dwynnychuk/SmartSmoker/PCB/BOMs/ConsolodatedBoms.xlsx

ConsolodatedBoms
Item | Qty | Reference(s) | Value | Board | Footprint | Manufacturer | Manufacturer Part Number | Vendor | Vendor Part Number
3 | 3 | C12, C15, C16 | 0.01uF 50V X7R 0603 | Digital | Capacitor_SMD:C_0603_1608Metric | Samsung Electro-Mechanics | CL10B103KB8NNNC | Digikey | 1276-1009-1-ND
4 | 5 | - | 10uF 16V X5R 0805 | Digital/Analog | Capacitor_SMD:C_0805_2012Metric | Samsung Electro-Mechanics | CL21A106KOQNNNE | Digikey | 1276-1096-1-ND
2 | 2 | - | 1 uF 25V X5R 0603 | Digital/Signal | Capacitor_SMD:C_0603_1608Metric | Samsung Electro-Mechanics | CL10A105KA8NNNC | Digikey | 1276-1102-1-ND
5 | 2 | - | 4.7uF 25V X5R 0805 | Digital/Signal | Capacitor_SMD:C_0805_2012Metric | Samsung Electro-Mechanics | CL21A475KAQNNNE | Digikey | 1276-1244-1-ND
1 | 16 | - | 0.1uF 50V X7R 0603 | All | Capacitor_SMD:C_0603_1608Metric | Samsung Electro-Mechanics | CL10B104KB8NNWC | Digikey | 1276-1935-1-ND
6 | 1 | C4 | 22uF 10V X5R 0805 | Digital | Capacitor_SMD:C_0805_2012Metric | Samsung Electro-Mechanics | CL21A226MPQNNNE | Digikey | 1276-2910-1-ND
46 | 1 | R9 | 250Ohm 0.1% 0603 | Digital | Resistor_SMD:R_0603_1608Metric | YAGEO | RT0603BRE07250RL | Digikey | 13-RT0603BRE07250RLCT-ND
45 | 1 | R8 | 50Ohm 0.1% 0603 | Digital | Resistor_SMD:R_0603_1608Metric | YAGEO | RT0603BRE0750RL | Digikey | 13-RT0603BRE0750RLCT-ND
8 | 1 | TP26 | Screen I2C - FOR BOM ONLY | Digital | Connector_PinHeader_2.54mm:PinHeader_1x04_P2.54mm_Vertical | Adafruit Industries LLC | 938 | Digikey | 1528-1512-ND
24 | 1 | U1 | LTR-329ALS-01 | Sensor | Customs:LTR-329ALS-01 | Lite-On Inc. | LTR-329ALS-01 | Digikey | 160-2160-1-ND
10 | 1 | PS2 | IRM-05-5 | Analog | Converter_ACDC:Converter_ACDC_MeanWell_IRM-05-xx_THT | MEAN WELL USA Inc. | IRM-05-5 | Digikey | 1866-3027-ND
11 | 1 | PS1 | IRM-10-3.3 | Analog | Converter_ACDC:Converter_ACDC_MeanWell_IRM-10-xx_THT | MEAN WELL USA Inc. | IRM-10-3.3 | Digikey | 1866-3031-ND
12 | 1 | U2 | ESP32-WROOM-32UE_16MB | Digital | Customs Smoker:ESP32-WROOM-32UE 16MB | Espressif Systems | ESP32-WROOM-32UE-N4 | Digikey | 1965-ESP32-WROOM-32UE-N4CT-ND
20 | 1 | J6 | SJ3-35053D | Analog | Customs Smoker:SAMESKY_SJ3-35053D | SameSky | SJ3-35053D | Digkey | 2223-SJ3-35053D-ND
16 | 3 | U1, U2, U3 | ALDP105W | Analog | Customs Smoker:PAN_ALD_PAN | Panasonic Electric Works | ALDP105W | Digikey | 255-3586-ND
13 | 1 | J1 | DF12NB_4.0_-20DP-0.5V_51_ | Analog | Customs Smoker:HRS_DF12NB_4.0_-20DP-0.5V_51_ | Hirose | DF12NB(4.0)-20DP-0.5V(51) | Digikey | 26-DF12NB(4.0)-20DP-0.5V(51)CT-ND
14 | 1 | J1 | DF12NC-20DS-0.5V_51_ | Digital | Customs Smoker:HRS_DF12NC-20DS-0.5V_51_ | Hirose | DF12NC-20DS-0.5V(51) | Digikey | 26-DF12NC-20DS-0.5V(51)CT-ND
18 | 1 | U3 | TPS2115APWR | Digital | Customs Smoker:PW8-M | Texas Instruments | TPS2115APWR | Digikey | 296-16940-1-ND
35 | 5 | - | 0 Ohm 0603 | Digital/Analog | Resistor_SMD:R_0603_1608Metric | YAGEO | RC0603JR-070RL | Digikey | 311-0.0GRCT-ND
37 | 6 | - | 150Ohm 1% 0603 | Digital/Analog | Resistor_SMD:R_0603_1608Metric | YAGEO | RC0603FR-07150RL | Digikey | 311-150HRCT-ND
42 | 1 | R13 | 22.1kOhm 1% 0603 | Digital | Resistor_SMD:R_0603_1608Metric | YAGEO | RC0603FR-0722K1L | Digikey | 311-22.1KHRCT-ND
43 | 1 | R20 | 47.5kOhm 1% 0603 | Digital | Resistor_SMD:R_0603_1608Metric | YAGEO | RC0603FR-0747K5L | Digikey | 311-47.5KHRCT-ND
38 | 4 | - | 64.9Ohm 1% 0603 | Digital/Analog | Resistor_SMD:R_0603_1608Metric | YAGEO | RC0603FR-0764R9L | Digikey | 311-64.9HRCT-ND
39 | 1 | R1 | 750Ohm 1% 0603 | Sensor | Resistor_SMD:R_0603_1608Metric | YAGEO | RC0603FR-07750RL | Digikey | 311-750HRCT-ND
40 | 3 | R1, R6, R9 | 91Ohm 1% 0603 | Analog | Resistor_SMD:R_0603_1608Metric | YAGEO | RC0603FR-0791RL | Digikey | 311-91.0HRCT-ND
29 | 1 | U6 | CP2102N-A02-GQFN24 | Digital | Package_DFN_QFN:QFN-24-1EP_4x4mm_P0.5mm_EP2.6x2.6mm | Silicon Labs | CP2102N-A02-GQFN24 | Digikey | 336-5887-ND
34 | 1 | U1 | AMS1117-3.3 | Digital | Package_TO_SOT_SMD:TO-252-2 | UMW | AMS1117CD-3.3 | Digikey | 4518-AMS1117CD-3.3CT-ND
26 | 7 | - | R 2.0V 20mA | Digital/Analog | LED_SMD:LED_0603_1608Metric | ams-OSRAM USA INC. | LO Q976-PS-25-0-20-R18 | Digikey | 475-LOQ976-PS-25-0-20-R18CT-ND
25 | 1 | U2 | LSM6DSMTR | Sensor | Customs:PQFN50P300X250X86-14N | STMicroelectronics | 497-16696-1-ND | Digikey | 497-16696-1-ND
49 | 1 | U3 | VL53L3CXV0DH/1 | Sensor | XDCR_VL53L3CXV0DH/1 | STMicroelectronics | VL53L3CXV0DH/1 | Digikey | 497-VL53L3CXV0DH/1CT-ND
15 | 1 | TC1 | Thermocouple_Block | Analog | Customs Smoker:K-TypeAdapter | Labfacility Ltd | XE-1139-001 | Digikey | 5425-XE-1139-001-ND
48 | 1 | AE1 | Antenna - FOR BOM ONLY | Digital | Symbol:KiCad-Logo2_5mm_SilkScreen | Pulse Electronics | W3921B0100 | Digikey | 553-W3921B0100-ND
28 | 3 | D1, D5, D7 | B 3.2 20mA 0603 | Analog | LED_SMD:LED_0603_1608Metric | Würth Elektronik | 150060BS75000 | Digikey | 732-4966-1-ND
27 | 1 | D1 | RED 1.8V 2mA 0603 | Sensor | LED_SMD:LED_0603_1608Metric | Rohm Semiconductor | CSL1901UW1 | Digikey | 846-CSL1901UW1CT-ND
44 | 2 | R3, R4 | 1.8kOhm 1% 0603 | Digital | Resistor_SMD:R_0603_1608Metric | TE Connectivity Passive Product | CRGCQ0603F1K8 | Digikey | A129691CT-ND
21 | 2 | S1, S2 | TL1015AF160QG | Digital | Customs Smoker:SW_TL1015AF160QG | E-Switch | TL1015AF160QG | Digikey | EG4344CT-ND
31 | 1 | D6 | SP0503BAHT | Digital | Package_TO_SOT_SMD:SOT-143 | Littelfuse Inc. | SP0503BAHTG | Digikey | F2715CT-ND
30 | 1 | U5 | MAX31855KASA | Digital | Package_SO:SOIC-8_3.9x4.9mm_P1.27mm | Analog Devices Inc./Maxim Integrated | MAX31855KASA+T | Digikey | MAX31855KASA+TCT-ND
33 | 1 | Q1 | MBT3904DW1 | Digital | Package_TO_SOT_SMD:SOT-363_SC-70-6 | onsemi | MBT3904DW1T1G | digikey | MBT3904DW1T1GOSCT-ND
32 | 3 | Q1, Q2, Q3 | 2N7002 | Analog | Package_TO_SOT_SMD:SOT-23 | Nexperia USA Inc. | 1727-4789-1-ND | Digikey | Nexperia USA Inc.
23 | 1 | MT1 | PEC11R-4215F-S0024 | Digital | Customs Smoker:XDCR_PEC11R-4215F-S0024 | Bourns Inc. | PEC11R-4220K-S0024 | Digikey | PEC11R-4220K-S0024-ND
17 | 5 | - | - | Digital/Signal | Customs Smoker:PRT-14417 | SparkFun Electronics | PRT-14417 | Digikey | PRT-14417-ND
19 | 3 | D2, D6, D8 | Schottky 30v 200mA | Analog | Customs Smoker:RB521S30T1G-M | onsemi | RB521S30T1G | Digikey | RB521S30T1GOSCT-ND
47 | 3 | R12, R13, R14 | 1kOhm 0.1% 0805 | Analog | Resistor_SMD:R_0805_2012Metric | Susumu | RG2012P-102-B-T5 | Digikey | RG20P1.0KBCT-ND
36 | 20 | - | 10K 1% 0603 | All | Resistor_SMD:R_0603_1608Metric | Stackpole Electronics Inc | RNCP0603FTD10K0 | Digikey | RNCP0603FTD10K0CT-ND
41 | 1 | R10 | 1kOhm 1% 0603 | Digital | Resistor_SMD:R_0603_1608Metric | Stackpole Electronics Inc | RNCP0603FTD1K00 | Digikey | RNCP0603FTD1K00CT-ND
22 | 3 | U4, U7, U8 | TLP2362TPR_E | Digital | Customs Smoker:TLP2362 | Toshiba Semiconductor and Storage | TLP2362(TPR,E | Digikey | TLP2362(TPRECT-ND
9 | 1 | J2 | 1050170001 | Digital | Connector_USB:USB_Micro-B_Molex-105017-0001 | Molex | 1050170001 | Digikey | WM1399CT-ND
7 | 4 | J2, J3, J4, J5 | 393570002 | Analog | CONN_393570002_MOL | Molex | 393570002 | Digikey | WM7877-ND
