dwynnychuk/SmartSmoker/PCB/CAD/ASMB-KTF0-0A306.step

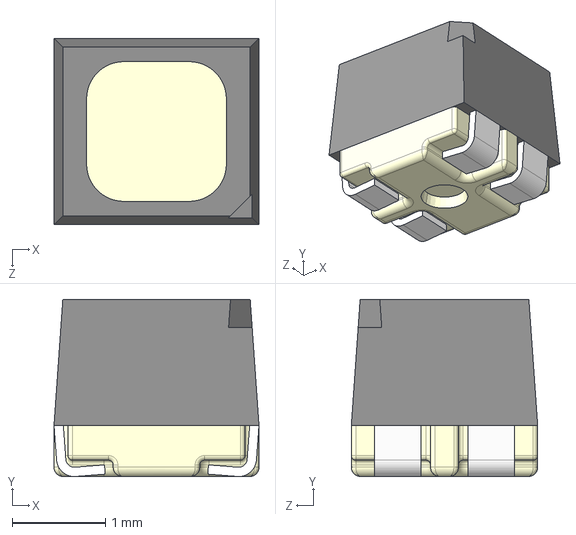
[picture p1: CAD file, 2023-08-07]
PCB/CAD/ASMB-KTF0-0A306.step
2.20 x 1.90 x 2.00 mm
