dwynnychuk/SmartSmoker/CAD/ControllerFaceplate01.step

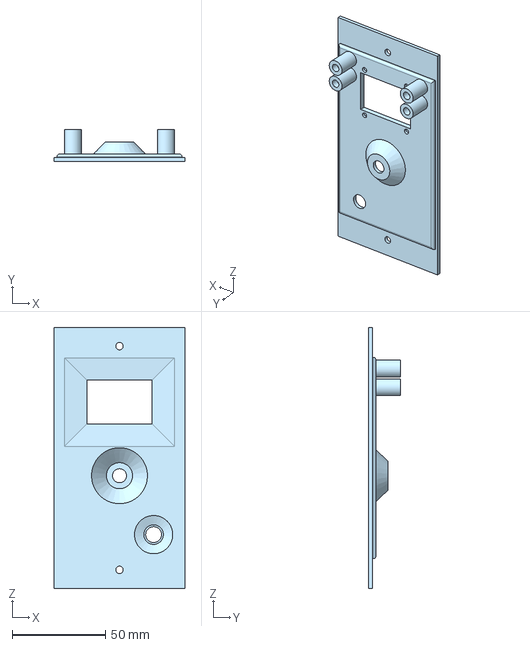
[picture p2: CAD file, 2025-05-30]
CAD/ControllerFaceplate01.step
70.0 x 17.0 x 140.0 mm
