dwynnychuk/SmartSmoker/PCB/CAD/power_supply_irm-10-3_3.stp

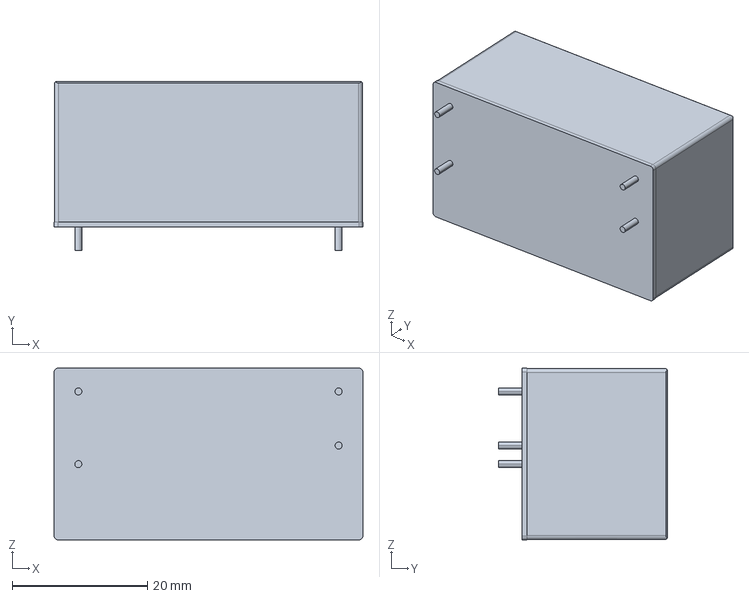
[picture p3: CAD file, 2025-04-23]
PCB/CAD/power_supply_irm-10-3_3.stp
45.7 x 25.0 x 25.4 mm
