dwynnychuk/SmartSmoker/CAD/DigitalAnalogSpacer.step

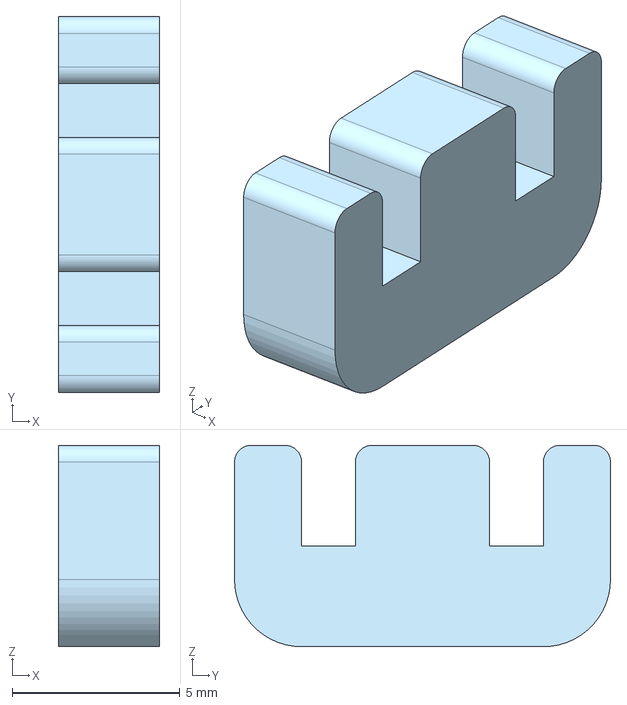
[picture p4: CAD file, 2025-05-26]
CAD/DigitalAnalogSpacer.step
3.00 x 11.2 x 6.00 mm
