dwynnychuk/SmartSmoker/PCB/CAD/Same_Sky_SJ3-35053D.step

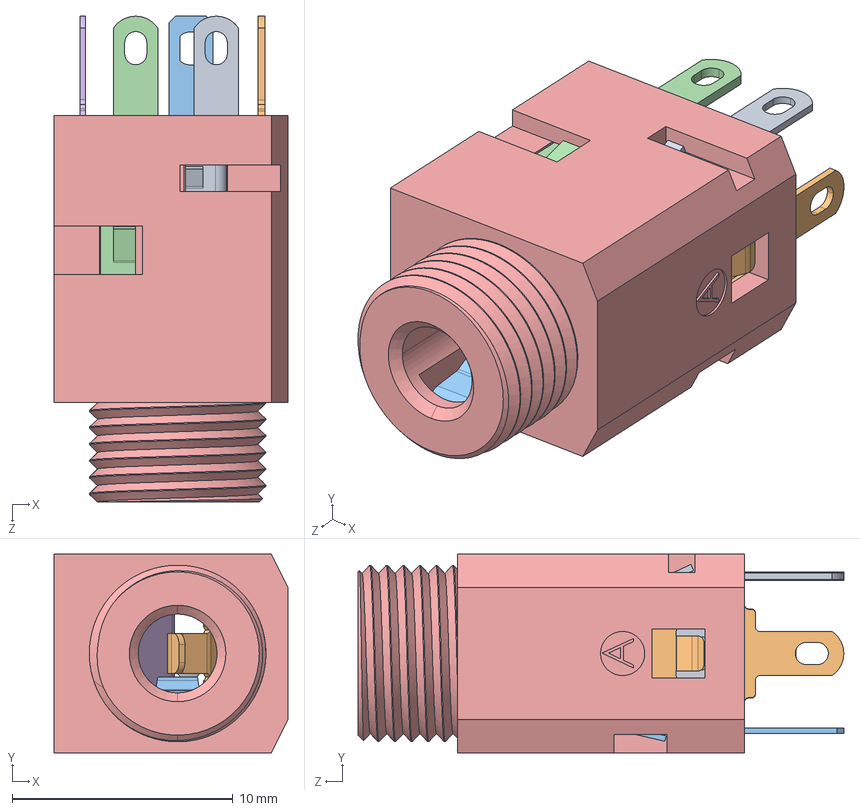
[picture p5: CAD file, 2025-04-21]
PCB/CAD/Same_Sky_SJ3-35053D.step
10.6 x 9.00 x 22.0 mm
