dwynnychuk/SmartSmoker/PCB/CAD/DF12NB_4.0_-20DP-0.5V_51_.step

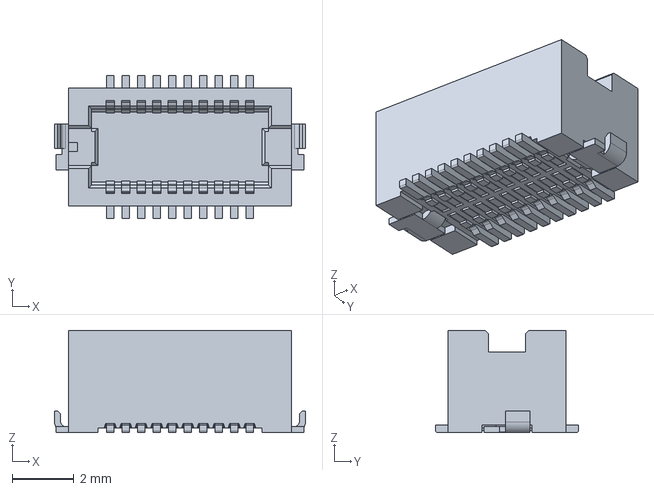
[picture p6: CAD file, 2025-04-20]
PCB/CAD/DF12NB_4.0_-20DP-0.5V_51_.step
8.10 x 4.60 x 3.30 mm
