dwynnychuk/SmartSmoker/PCB/LID PCB/CAD/SOIC16_NARROW_VIS.step

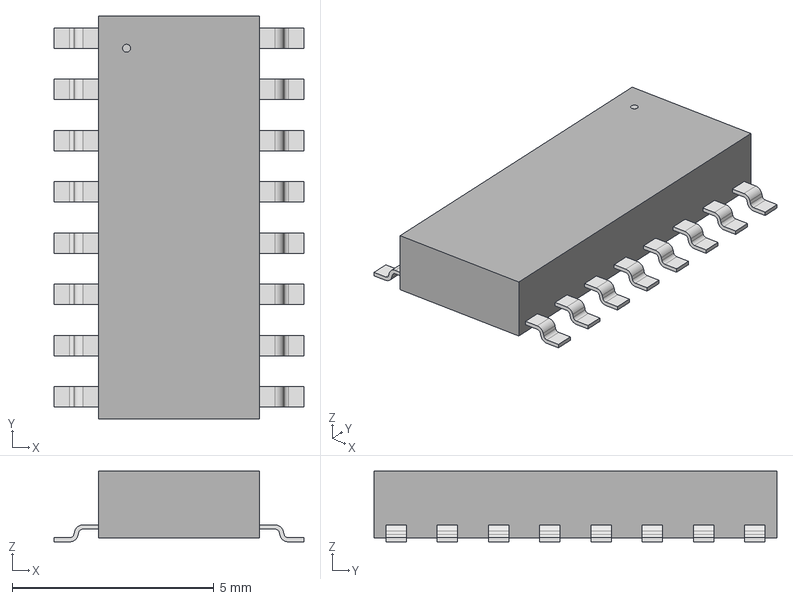
[picture p7: CAD file, 2023-05-28]
PCB/LID PCB/CAD/SOIC16_NARROW_VIS.step
6.20 x 9.98 x 1.75 mm
