dwynnychuk/SmartSmoker/PCB/CAD/DF12NC-20DS-0.5V_51_.step

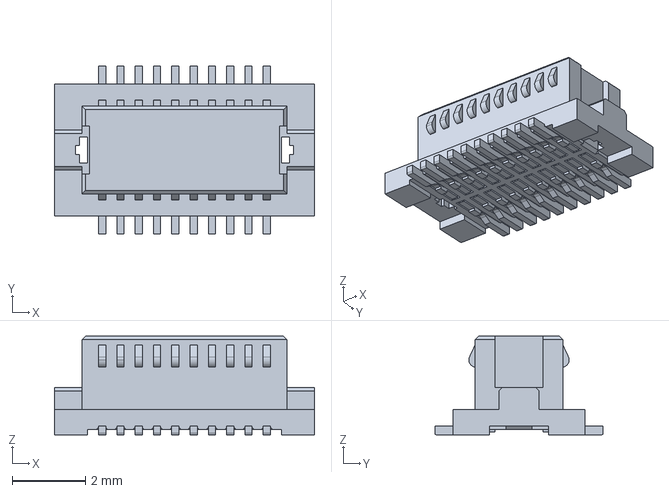
[picture p8: CAD file, 2025-04-20]
PCB/CAD/DF12NC-20DS-0.5V_51_.step
7.10 x 4.60 x 2.70 mm
