dwynnychuk/SmartSmoker/PCB/CAD/PRT-14417.STEP

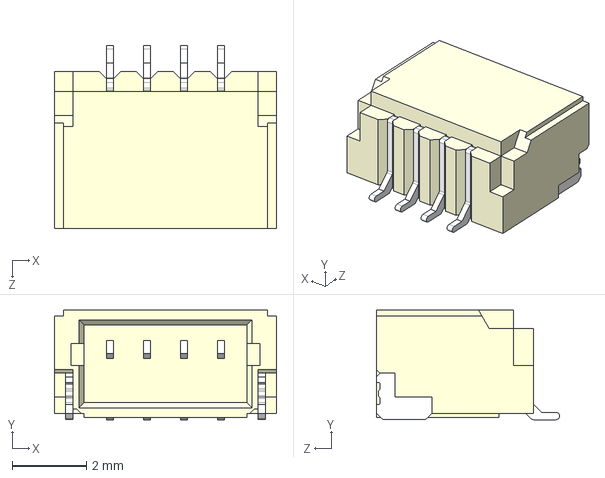
[picture p9: CAD file, 2025-03-30]
PCB/CAD/PRT-14417.STEP
6.00 x 2.96 x 4.95 mm
