dwynnychuk/SmartSmoker/PCB/LID PCB/CAD/TL1015AF160QG.step

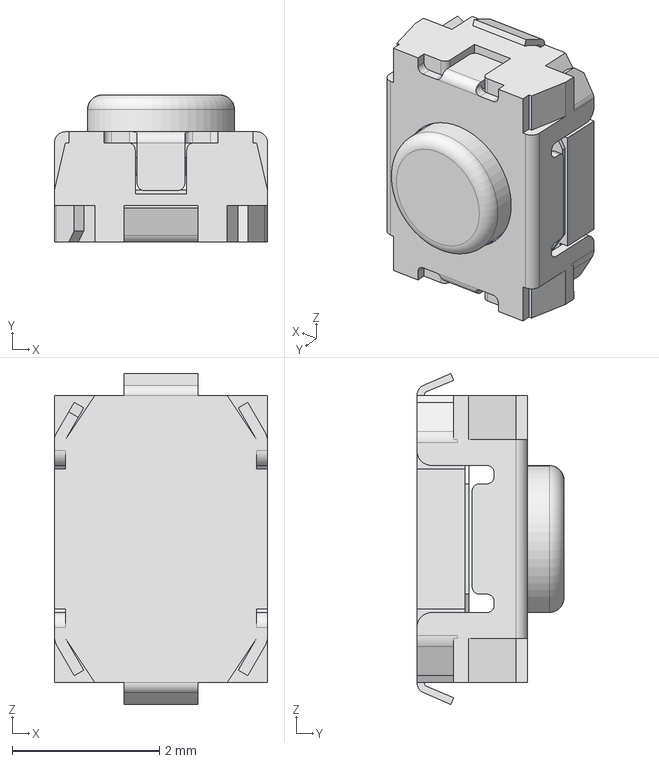
[picture p10: CAD file, 2023-05-28]
PCB/LID PCB/CAD/TL1015AF160QG.step
2.90 x 2.00 x 4.50 mm
