dwynnychuk/SmartSmoker/PCB/CAD/STM811SW16F.step

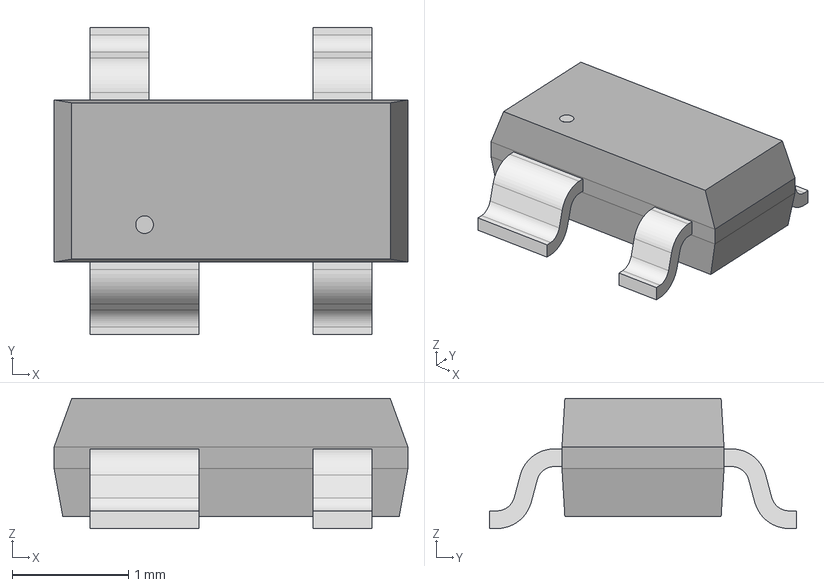
[picture p11: CAD file, 2025-03-19]
PCB/CAD/STM811SW16F.step
3.05 x 2.64 x 1.12 mm
