dwynnychuk/SmartSmoker/PCB/LID PCB/CAD/ESP32-WROOM-32UE-N4--3DModel-STEP-269445.STEP

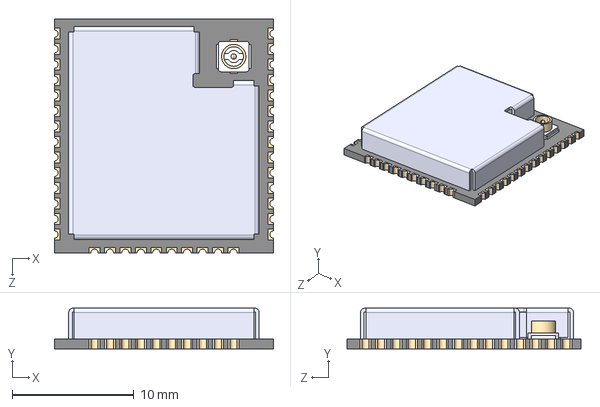
[picture p12: CAD file, 2023-05-28]
PCB/LID PCB/CAD/ESP32-WROOM-32UE-N4--3DModel-STEP-269445.STEP
18.0 x 3.35 x 19.2 mm
