dwynnychuk/SmartSmoker/PCB/CAD/SN74LVC1G3157DBVR.stp

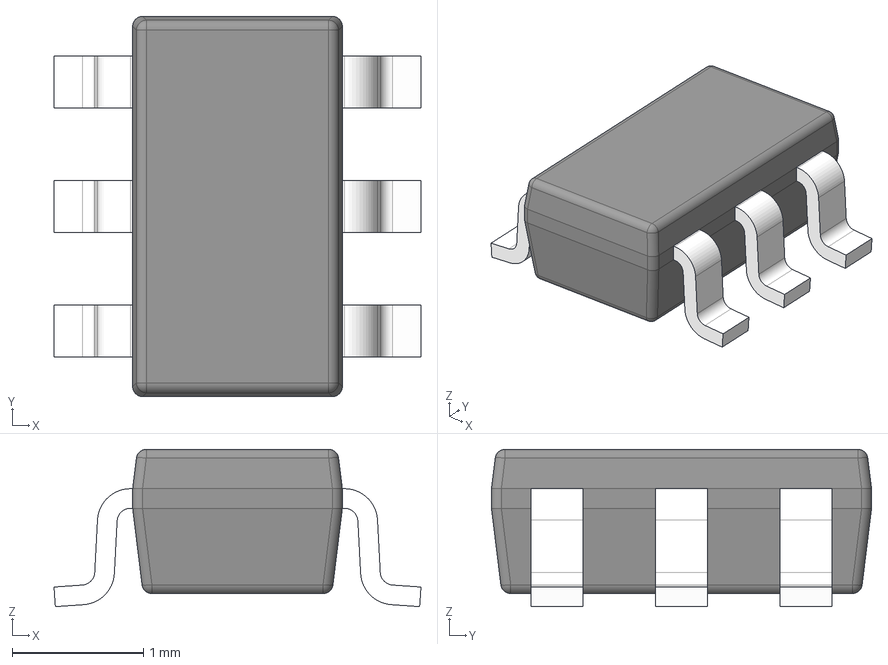
[picture p13: CAD file, 2025-03-17]
PCB/CAD/SN74LVC1G3157DBVR.stp
2.80 x 2.90 x 1.20 mm
BODY-SOT
LEAD-SOT x 6
