dwynnychuk/SmartSmoker/PCB/LID PCB/CAD/LSM6DSMTR.step

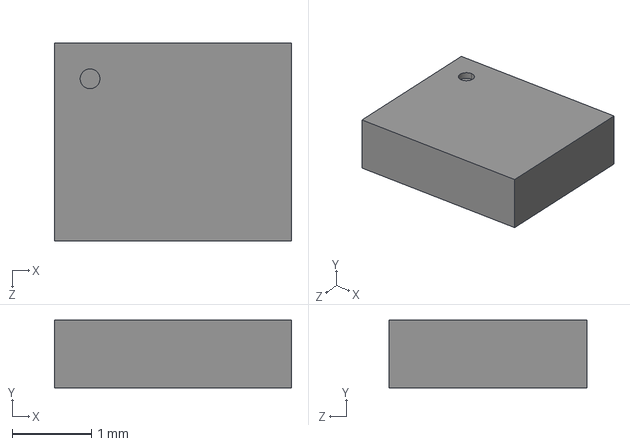
[picture p14: CAD file, 2023-05-28]
PCB/LID PCB/CAD/LSM6DSMTR.step
3.00 x 0.86 x 2.50 mm
