dwynnychuk/SmartSmoker/PCB/CAD/RB521S30T1G.step

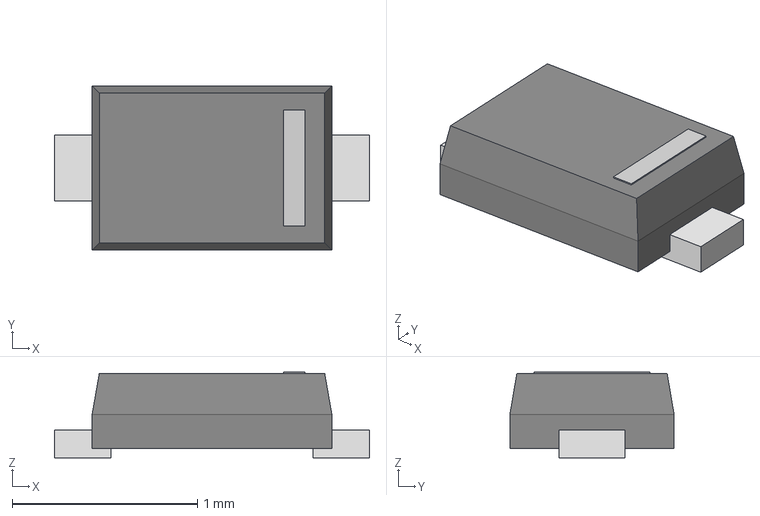
[picture p15: CAD file, 2025-03-14]
PCB/CAD/RB521S30T1G.step
1.70 x 0.888 x 0.464 mm
