dwynnychuk/SmartSmoker/PCB/LID PCB/CAD/VESM.step

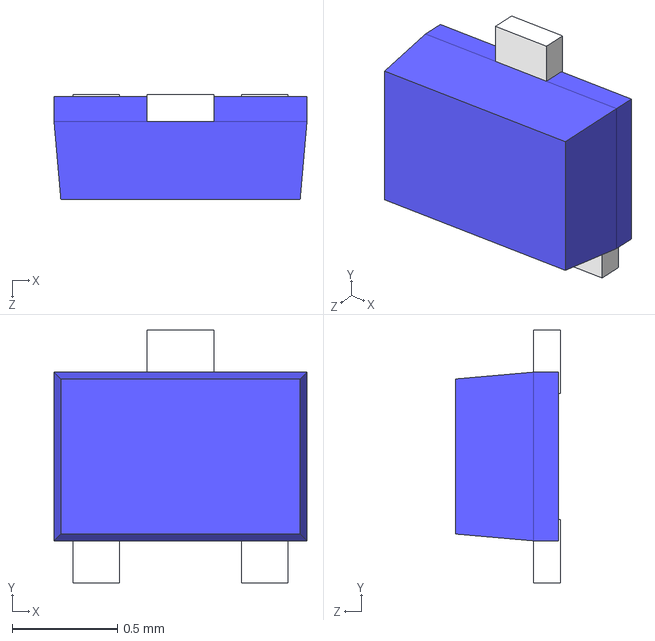
[picture p16: CAD file, 2023-05-28]
PCB/LID PCB/CAD/VESM.step
1.20 x 1.20 x 0.5 mm
