dwynnychuk/SmartSmoker/PCB/CAD/5pin SO6.step

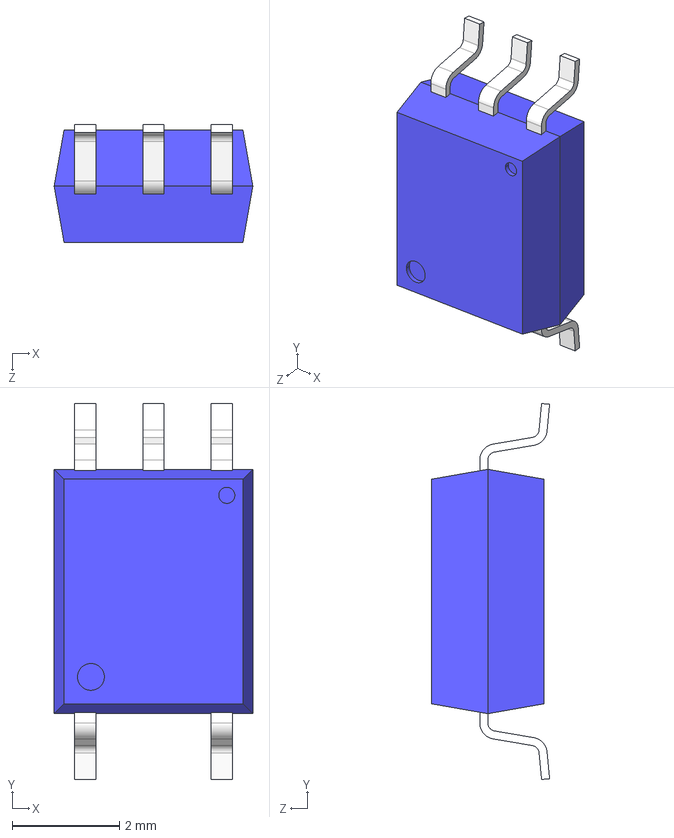
[picture p17: CAD file, 2025-03-11]
PCB/CAD/5pin SO6.step
3.70 x 7.00 x 2.20 mm
