dwynnychuk/SmartSmoker/PCB/CAD/PW0008A.stp

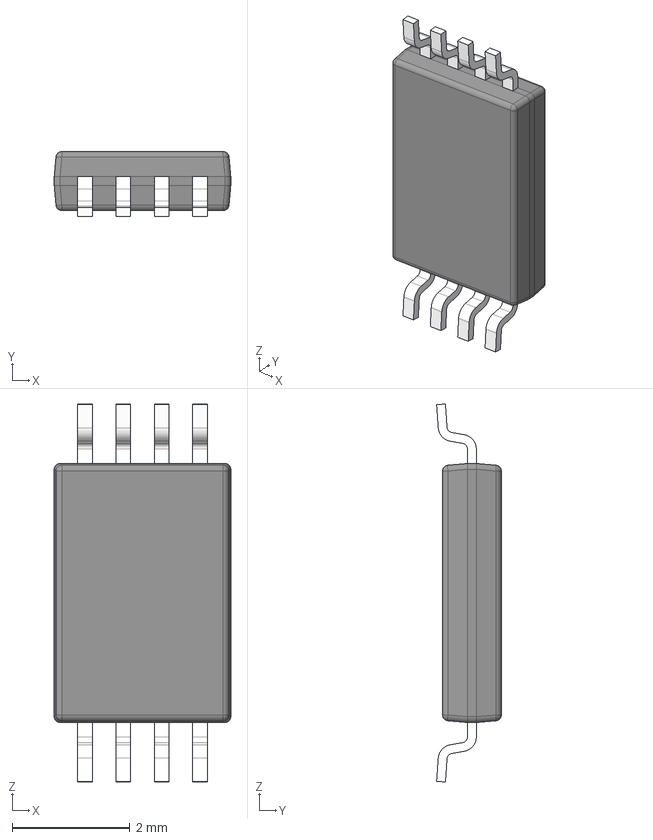
[picture p18: CAD file, 2025-03-09]
PCB/CAD/PW0008A.stp
3.00 x 1.10 x 6.42 mm
BODY-SO
LEAD-SO x 8
PIN1-ID
