dwynnychuk/SmartSmoker/PCB/LID PCB/CAD/VL53L3CXV0DH_1.step

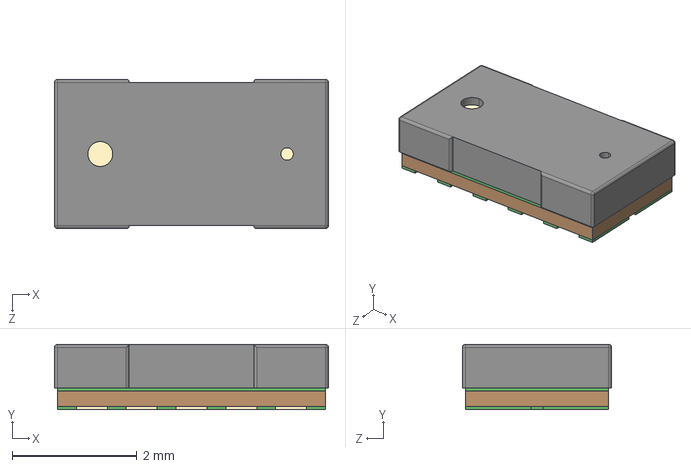
[picture p19: CAD file, 2023-05-28]
PCB/LID PCB/CAD/VL53L3CXV0DH_1.step
4.40 x 1.05 x 2.40 mm
