dwynnychuk/SmartSmoker/PCB/CAD/PAN_ALD_PAN.step

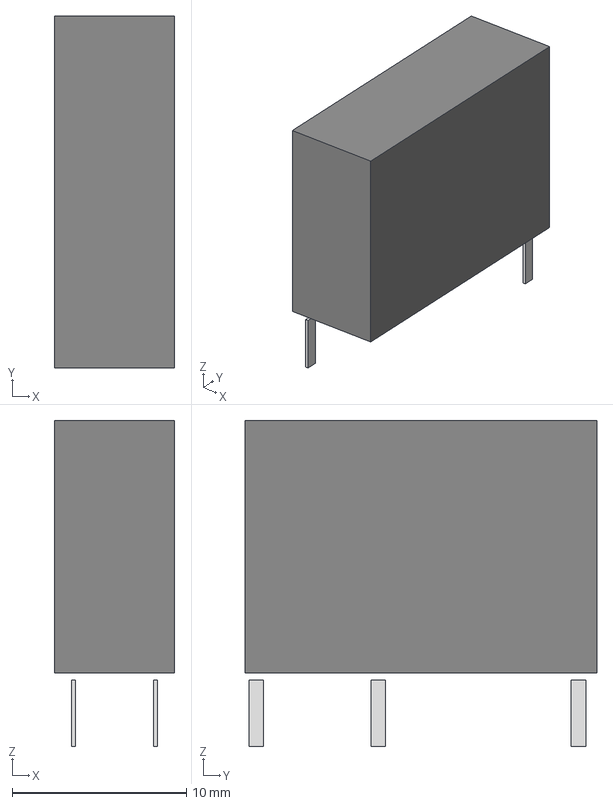
[picture p20: CAD file, 2025-03-09]
PCB/CAD/PAN_ALD_PAN.step
6.91 x 20.2 x 18.7 mm
