dwynnychuk/SmartSmoker/PCB/LID PCB/CAD/LTR-329ALS-01_LTO.step

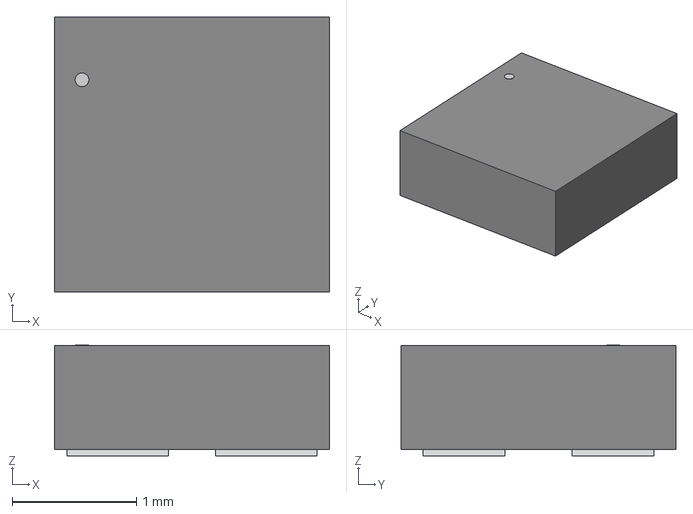
[picture p21: CAD file, 2023-02-14]
PCB/LID PCB/CAD/LTR-329ALS-01_LTO.step
2.21 x 2.21 x 0.892 mm
