dwynnychuk/SmartSmoker/PCB/CAD/DM3CS-SF.stp

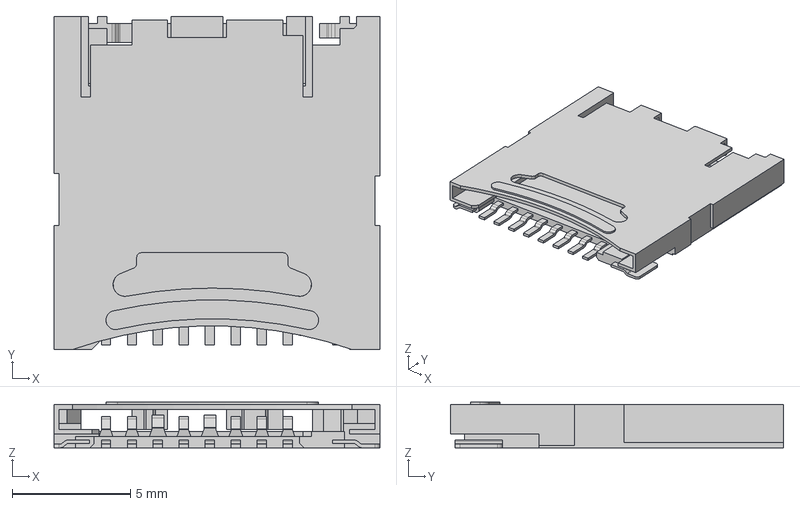
[picture p22: CAD file, 2024-03-13]
PCB/CAD/DM3CS-SF.stp
13.8 x 14.1 x 1.93 mm
