dwynnychuk/SmartSmoker/PCB/CAD/PEC11R-4220K-S0024.STEP

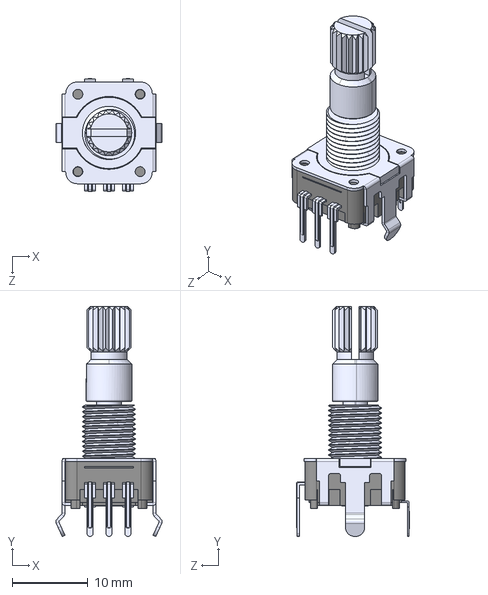
[picture p23: CAD file, 2024-03-08]
PCB/CAD/PEC11R-4220K-S0024.STEP
14.0 x 30.3 x 14.9 mm
