dwynnychuk/SmartSmoker/PCB/CAD/MJ-3502.step

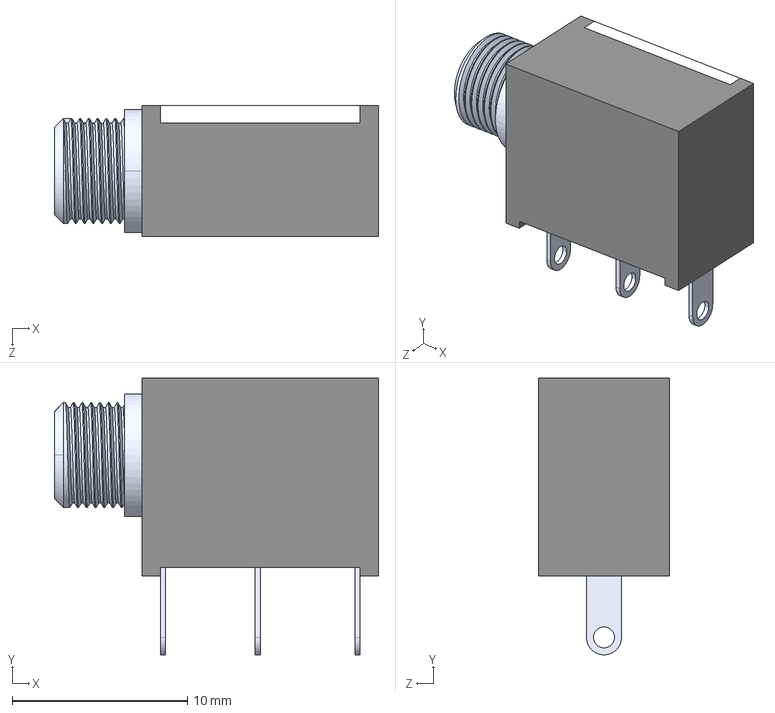
[picture p24: CAD file, 2024-03-08]
PCB/CAD/MJ-3502.step
18.5 x 15.8 x 7.50 mm
