dwynnychuk/SmartSmoker/PCB/CAD/TPS2115APWR.step

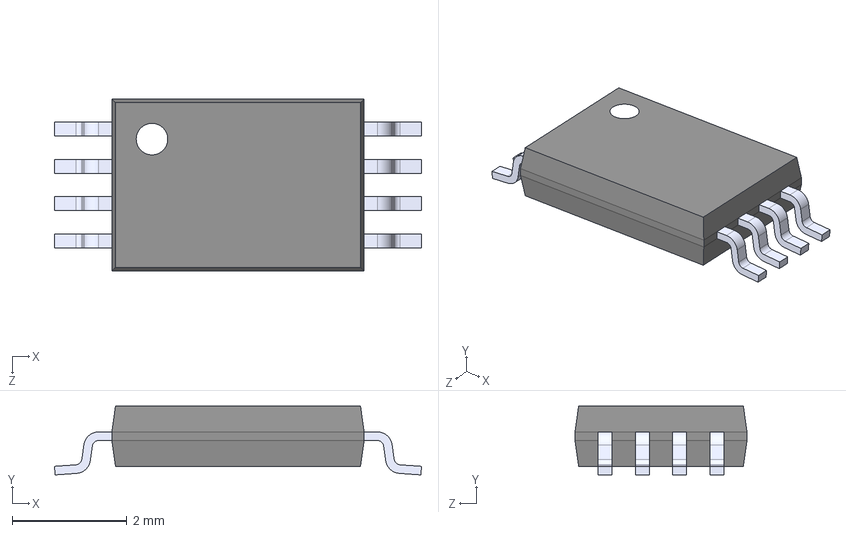
[picture p25: CAD file, 2024-03-07]
PCB/CAD/TPS2115APWR.step
6.40 x 1.20 x 3.00 mm
