dwynnychuk/SmartSmoker/PCB/CAD/DCK0006A.stp

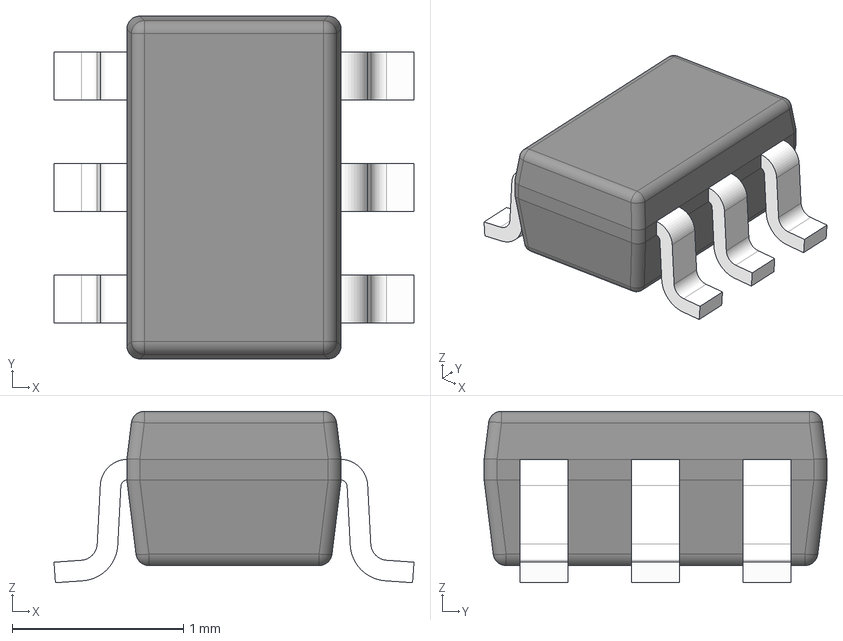
[picture p26: CAD file, 2024-03-06]
PCB/CAD/DCK0006A.stp
2.10 x 2.00 x 1.00 mm
BODY-SOT
LEAD-SOT x 6
PIN1-ID
