dwynnychuk/SmartSmoker/PCB/CAD/SIP4_CPC1966Y_LTF.step

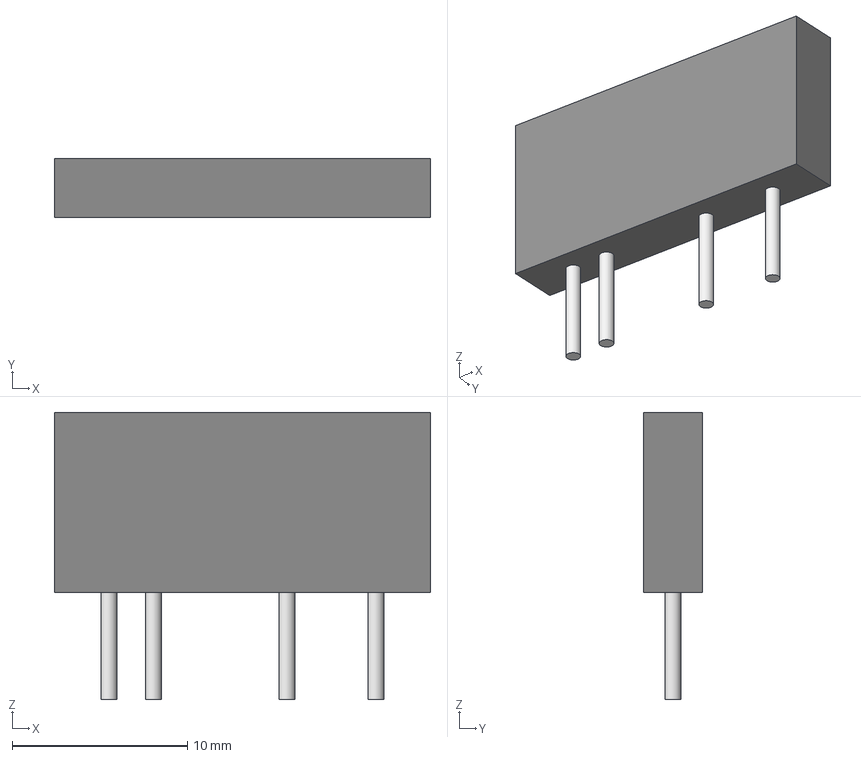
[picture p27: CAD file, 2023-11-19]
PCB/CAD/SIP4_CPC1966Y_LTF.step
21.5 x 3.35 x 16.4 mm
