dwynnychuk/SmartSmoker/PCB/CAD/CPC1966B_IXY.step

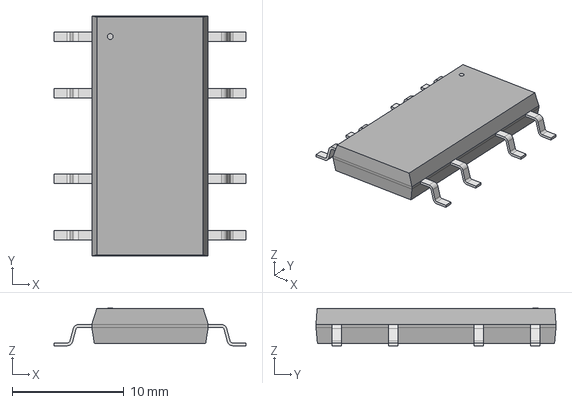
[picture p28: CAD file, 2023-08-09]
PCB/CAD/CPC1966B_IXY.step
17.1 x 21.5 x 3.35 mm
