dwynnychuk/SmartSmoker/PCB/CAD/MEM2051-00-195-00-A--3DModel-STEP-1.STEP

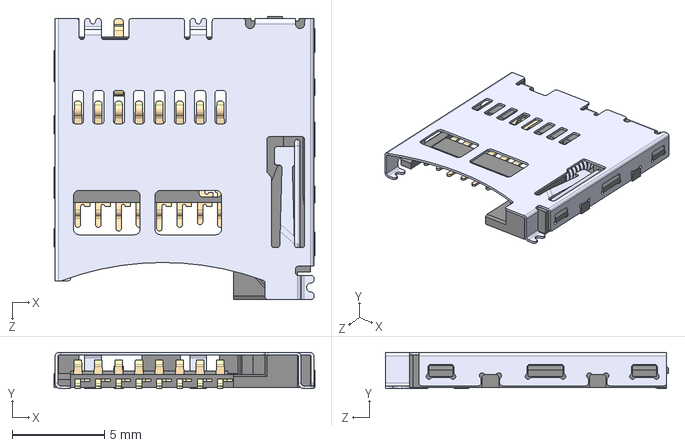
[picture p29: CAD file, 2023-08-07]
PCB/CAD/MEM2051-00-195-00-A--3DModel-STEP-1.STEP
14.1 x 1.95 x 15.3 mm
