dwynnychuk/SmartSmoker/PCB/CAD/PEC11R-4215F-S0024.step

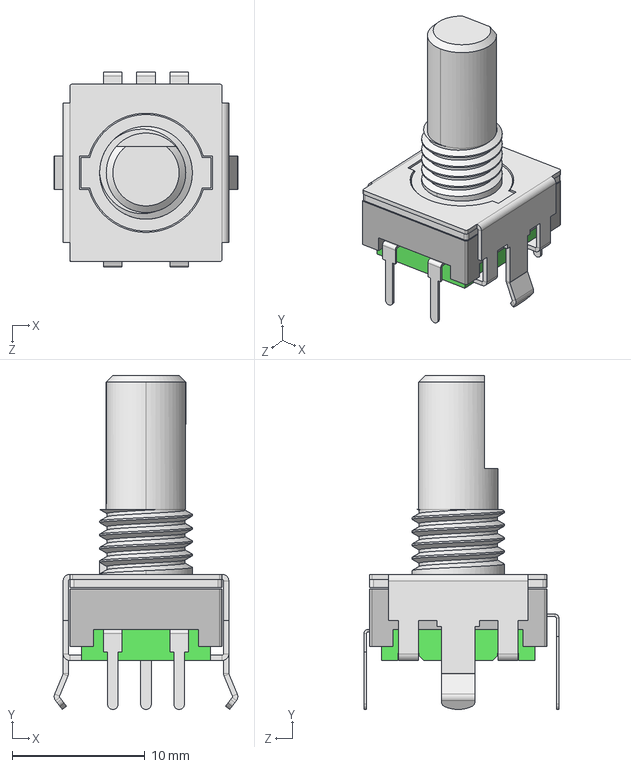
[picture p30: CAD file, 2023-08-07]
PCB/CAD/PEC11R-4215F-S0024.step
13.9 x 25.2 x 14.7 mm
