dwynnychuk/SmartSmoker/PCB/CAD/RR511D1121.step

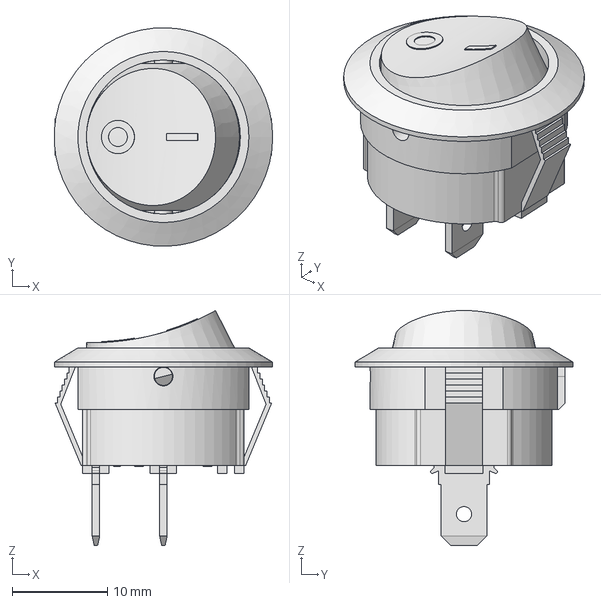
[picture p31: CAD file, 2023-08-07]
PCB/CAD/RR511D1121.step
23.0 x 23.0 x 24.7 mm
