dwynnychuk/SmartSmoker/PCB/CAD/VARS_B72214S_15P5X5P6-7P5-2P2_TDK.step

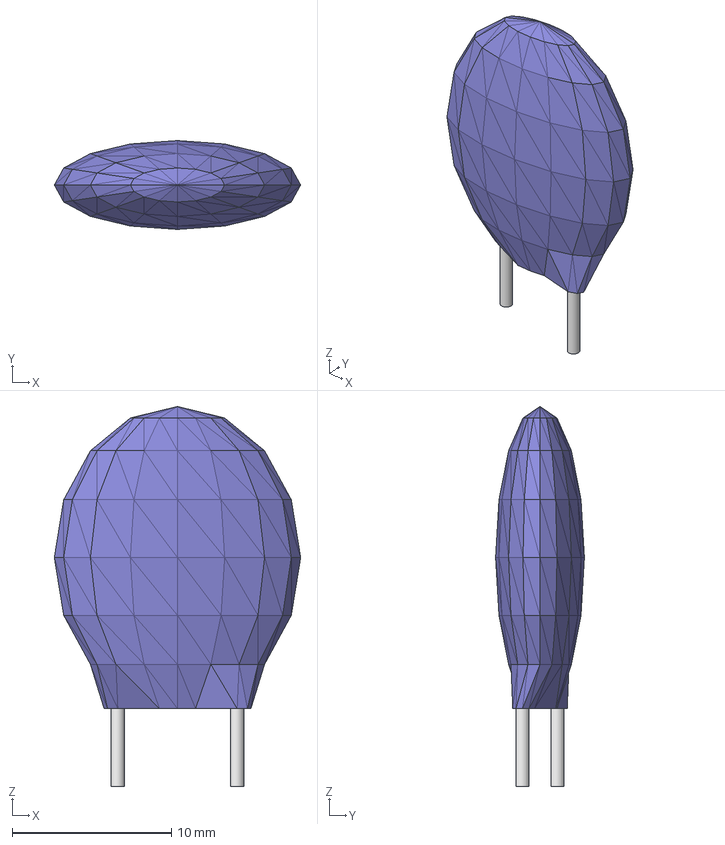
[picture p32: CAD file, 2023-07-29]
PCB/CAD/VARS_B72214S_15P5X5P6-7P5-2P2_TDK.step
15.5 x 5.59 x 23.9 mm
