dwynnychuk/SmartSmoker/(list of files, cad)

Other CAD files:
PCB/CAD/105017-0001.step
PCB/CAD/1051330001.stp
PCB/CAD/393570002.stp
PCB/CAD/430450400--3DModel-STEP-1.STEP
PCB/LID PCB/CAD/105017-0001.step
PCB/LID PCB/CAD/393570002.stp
PCB/LID PCB/CAD/430450400--3DModel-STEP-1.STEP
