dwynnychuk/SmartSmoker/PCB/Main PCB/REV B/AnalogPCB.kicad_pcb

## KiCad design PCB/Main PCB/REV B/AnalogPCB.kicad_pcb (2026-09-20, an earlier design)

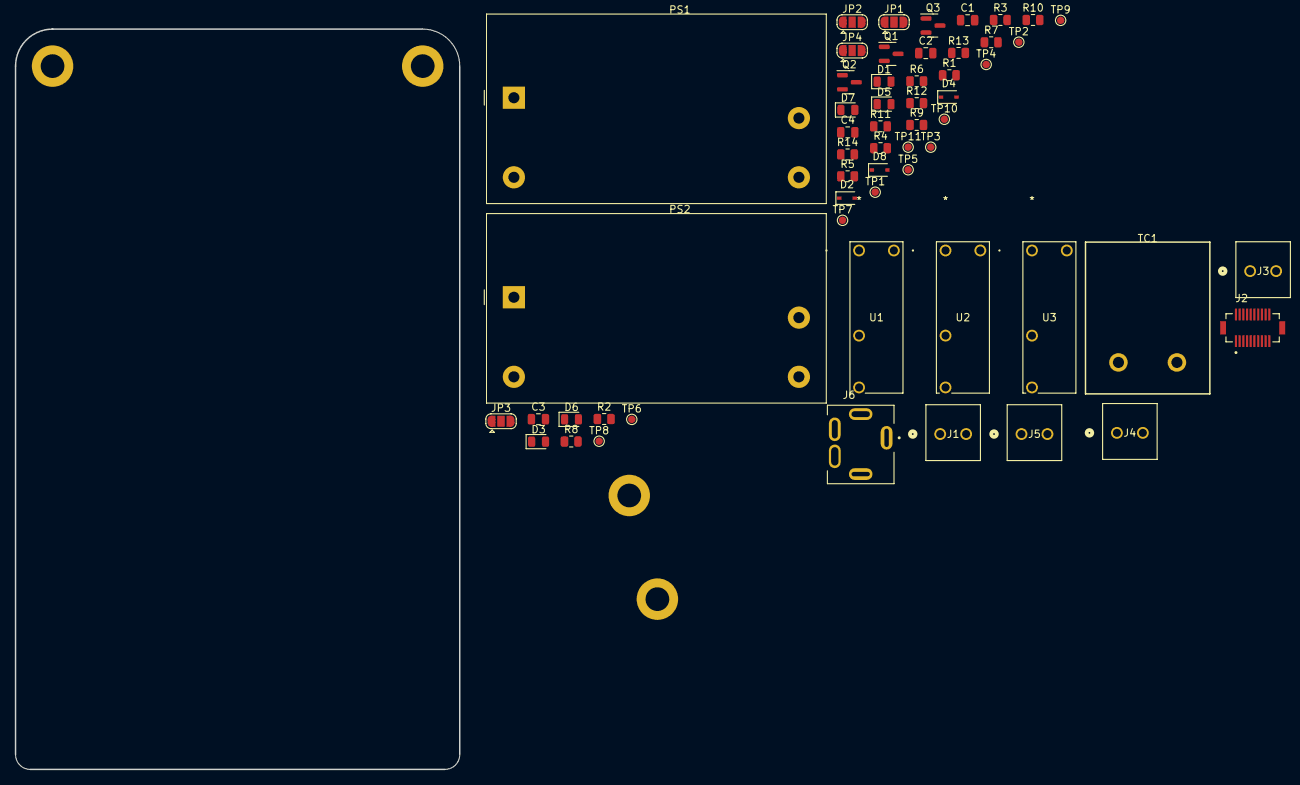
[picture p33: board PCB/Main PCB/REV B/AnalogPCB.kicad_pcb from above]

Board: 2 copper layers, 60.0 x 100.0 mm, 60 parts (0 on the bottom side), 31 nets, no tracks yet.

Parts:
C1, C3: 0.1uF 50V X7R 0805; C_0805_2012Metric
C2, C4: 10uF 16V X5R 0805; C_0805_2012Metric
D1, D3, D7: B 3.2V 20mA 0805; LED_0805_2012Metric
D2, D4, D8: Schottky 30v 200mA; D_SOD-323
D5, D6: R 2.0V 20mA; LED_0805_2012Metric
H1, H2, H3, H4: MountingHole; MountingHole_3.2mm_M3_DIN965_Pad
J1, J3, J4, J5: 393570002; CONN_393570002_MOL
J2: DF12NB_4.0_-20DP-0.5V_51_; HRS_DF12NB_4.0_-20DP-0.5V_51_
J6: SJ3-35053D; SAMESKY_SJ3-35053D
JP1, JP2, JP3, JP4: SolderJumper_3_Open; SolderJumper-3_P1.3mm_Open_RoundedPad1.0x1.5mm
PS1: IRM-10-3.3; Converter_ACDC_MeanWell_IRM-10-xx_THT
PS2: IRM-05-5; Converter_ACDC_MeanWell_IRM-05-xx_THT
Q1, Q2, Q3: 2N7002; SOT-23
R1, R4, R9: 91Ohm 1% 0805; R_0805_2012Metric
R2, R5, R10: 10K 1% 0805; R_0805_2012Metric
R3, R6, R11: 0 Ohm 0805; R_0805_2012Metric
R7: 150Ohm 1% 0805; R_0805_2012Metric
R8: 64.9Ohm 1% 0805; R_0805_2012Metric
R12, R13, R14: 1kOhm 0.1% 0805; R_0805_2012Metric
TC1: Thermocouple_Block; K-TypeAdapter
TP1, TP2, TP3, TP4, TP5, TP6, TP7, TP8, TP9, TP10, TP11: TP; TestPoint_Pad_D1.0mm
U1, U2, U3: ALDP105W; PAN_ALD_PAN

Connections:
+3.3VA: C1.2, C2.1, J2.1, J2.3, J2.5, J2.7, JP1.3 (B), JP2.3 (B), JP3.3 (B), PS1.4 (+Vo), R8.1, R12.1, R13.1, TP4.1, TP10.1
+5V: C3.2, C4.1, D2.1 (K), D4.1 (K), D8.1 (K), J2.9, J2.11, PS2.4 (+Vo), R1.1, R4.1, R7.1, R9.1, TP5.1, U1.1, U2.1, U3.1
/AC_L: J1.1, PS1.2 (AC/L), PS2.2 (AC/L), TP3.1, U1.2, U2.2, U3.2
/AC_N: J1.2, J3.2, J4.2, J5.2, PS1.1 (AC/N), PS2.1 (AC/N), TP1.1
/Auger_+: J5.1, U1.3
/Fan_+: J4.1, U3.3
/Ignitor_+: J3.1, U2.3
/MeatProbe+: J2.19, R12.2, R14.1
/MeatProbe-: J2.20, J6.3, R13.2
/MeatProbeSleeve: J6.1, JP4.3 (B)
/MeatProbeTip: J6.2, JP4.1 (A)
/Opto_Auger: J2.15, Q1.1 (G), R2.2, TP2.1
/Opto_Fan: J2.16, Q3.1 (G), R10.2, TP9.1
/Opto_Ignitor: J2.17, Q2.1 (G), R5.2, TP6.1
/Probe1+: J2.13, TC1.1 (+)
/Probe1-: J2.14, TC1.2 (-)
GND: C1.1, C2.2, C3.1, C4.2, D5.1 (K), D6.1 (K), J2.2, J2.4, J2.6, J2.8, J2.10, J2.12, J2.18, JP1.1 (A), JP2.1 (A), JP3.1 (A), JP4.2 (C), PS1.3 (-Vo), PS2.3 (-Vo), Q1.2 (S), Q2.2 (S), Q3.2 (S), R14.2, TP11.1
unnamed: D1.1 (K), Q1.3 (D), R3.2
unnamed: D1.2 (A), R1.2
unnamed: D2.2 (A), R3.1, U1.4
unnamed: D3.2 (A), R4.2
unnamed: D5.2 (A), R7.2, TP7.1
unnamed: D7.2 (A), R9.2
unnamed: JP1.2 (C), R2.1
unnamed: JP2.2 (C), R5.1
unnamed: JP3.2 (C), R10.1
unnamed: D3.1 (K), Q2.3 (D), R6.2
unnamed: D7.1 (K), Q3.3 (D), R11.2
unnamed: D6.2 (A), R8.2, TP8.1
unnamed: D4.2 (A), R6.1, U2.4
unnamed: D8.2 (A), R11.1, U3.4
