dwynnychuk/SmartSmoker/PCB/Main PCB/REV C/AnalogPCB.kicad_pcb

## KiCad design PCB/Main PCB/REV C/AnalogPCB.kicad_pcb (2026-09-20)

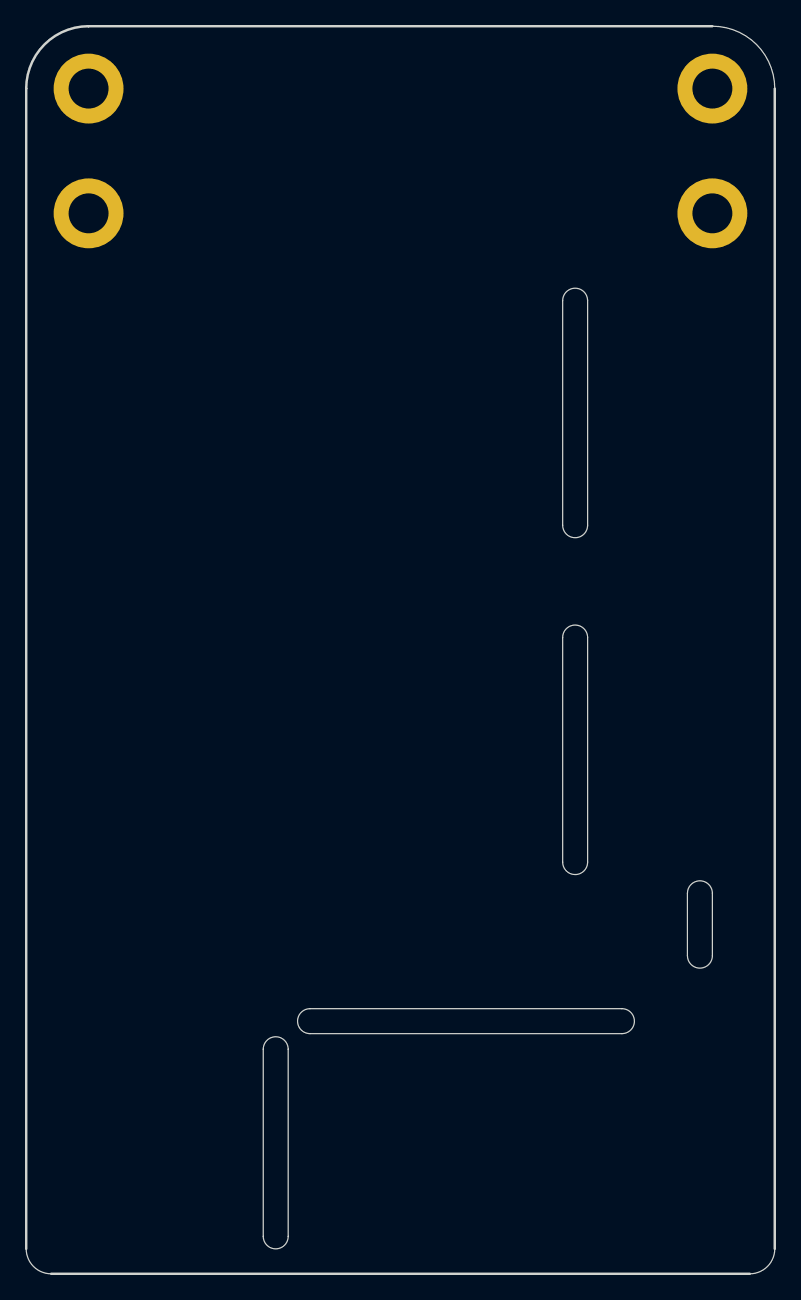
[picture p34: board PCB/Main PCB/REV C/AnalogPCB.kicad_pcb from above]

Board: 2 copper layers, 60.0 x 100.0 mm, 5 parts (1 on the bottom side), 3 nets, no tracks yet.

Parts:
H1, H2, H3, H4: MountingHole; MountingHole_3.2mm_M3_DIN965_Pad
J2: DF12NB_4.0_-20DP-0.5V_51_; HRS_DF12NB_4.0_-20DP-0.5V_51_

Connections:
+3.3VA: J2.1, J2.3, J2.5, J2.7
+5V: J2.9, J2.11
GND: J2.2, J2.4, J2.6, J2.8, J2.10, J2.12, J2.18
