dwynnychuk/SmartSmoker/PCB/Main PCB/REV B/DigitalPCB.kicad_pcb

## KiCad design PCB/Main PCB/REV B/DigitalPCB.kicad_pcb (2025-05-20, an earlier design)

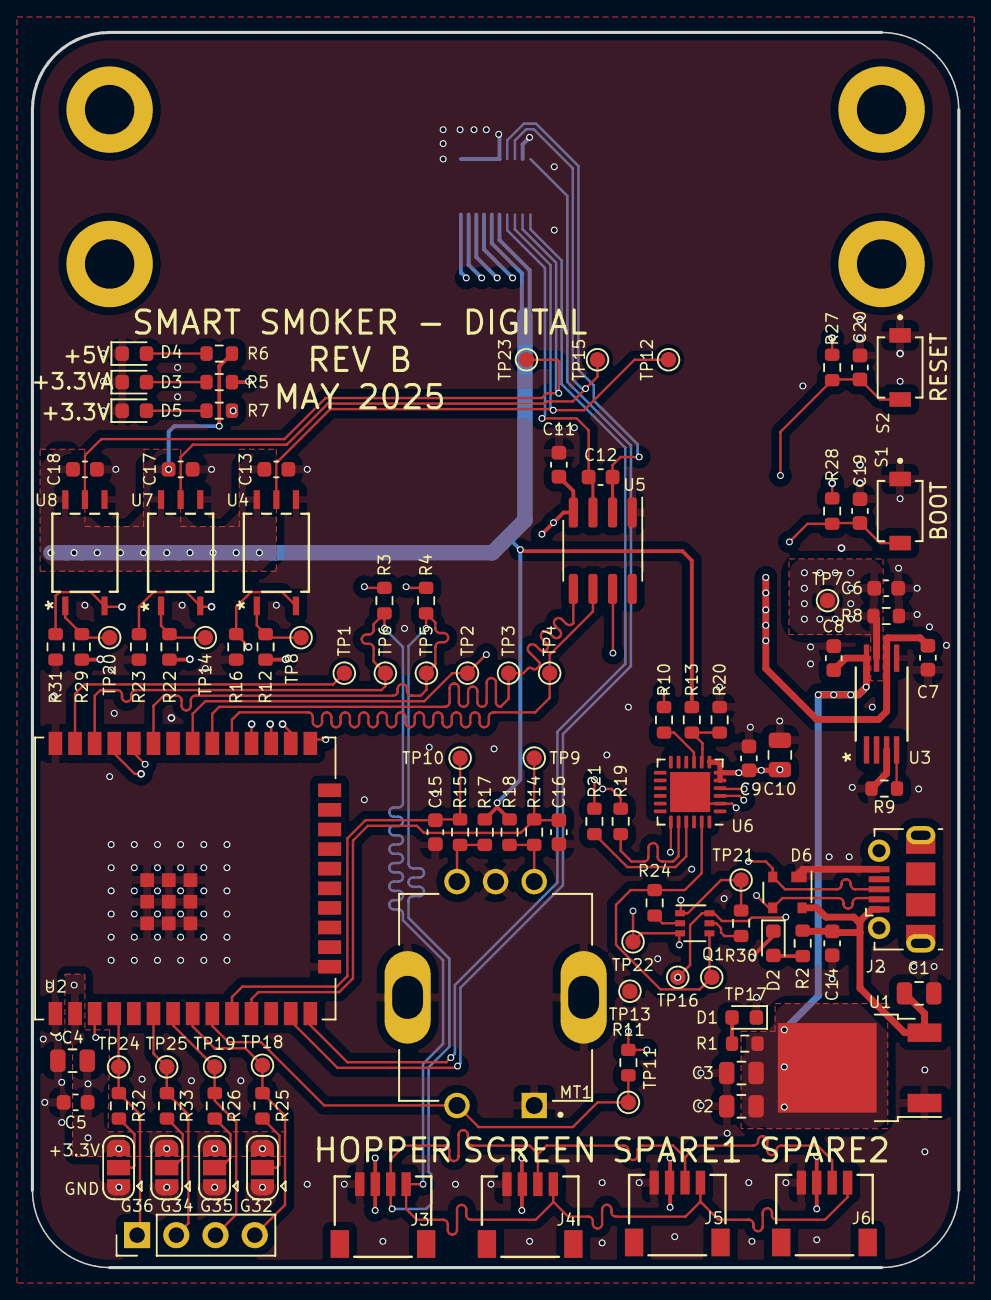
[picture p35: board DigitalPCB.kicad_pcb from above]

Board: 4 copper layers, 60.0 x 80.0 mm, 111 parts (1 on the bottom side), 58 nets.

Parts:
C1, C2, C3: 10uF 16V X5R 0805; C_0805_2012Metric
C4: 22uF 10V X5R 0805; C_0805_2012Metric
C5, C7, C8, C9, C11, C13, C14, C17, C18, C19, C20: 0.1uF 50V X7R 0603; C_0603_1608Metric
C6: 1uF 16V X7R 0603; C_0603_1608Metric
C10: 4.7uF 25V X5R 0805; C_0805_2012Metric
C12, C15, C16: 0.01uF 50V X7R 0603; C_0603_1608Metric
D1, D2, D3, D4, D5: R 2.0V 20mA; LED_0603_1608Metric
D6: SP0503BAHT; SOT-143
H1, H2, H3, H4: MountingHole; MountingHole_3.2mm_M3_DIN965_Pad
J1: DF12NC-20DS-0.5V_51_; HRS_DF12NC-20DS-0.5V_51_
J2: 1050170001; USB_Micro-B_Molex-105017-0001
J3: Hopper; PRT-14417
J4: Screen; PRT-14417
J5: Spare1; PRT-14417
J6: Spare2; PRT-14417
JP1, JP2, JP3, JP4: SolderJumper_3_Open; SolderJumper-3_P1.3mm_Open_RoundedPad1.0x1.5mm
MT1: PEC11R-4215F-S0024; XDCR_PEC11R-4215F-S0024
Q1: MBT3904DW1; SOT-363_SC-70-6
R1, R5, R7: 64.9Ohm 1% 0603; R_0603_1608Metric
R2, R6, R12, R22, R29: 150Ohm 1% 0603; R_0603_1608Metric
R3, R4: 1.8kOhm 1% 0603; R_0603_1608Metric
R8: 50Ohm 0.1% 0603; R_0603_1608Metric
R9: 250Ohm 0.1% 0603; R_0603_1608Metric
R10: 1kOhm 1% 0603; R_0603_1608Metric
R11, R14, R15, R16, R17, R18, R23, R24, R25, R26, R27, R28, R30, R31, R32, R33: 10K 1% 0603; R_0603_1608Metric
R13: 22.1kOhm 1% 0603; R_0603_1608Metric
R19, R21: 0Ohm 0603; R_0603_1608Metric
R20: 47.5kOhm 1% 0603; R_0603_1608Metric
S1, S2: TL1015AF160QG; SW_TL1015AF160QG
TP1, TP2, TP3, TP4, TP5, TP6, TP7, TP8, TP9, TP10, TP11, TP12, TP13, TP14, TP15, TP16, TP17, TP18, TP19, TP20, TP21, TP22, TP23, TP24, TP25: TP; TestPoint_Pad_D1.0mm
TP27: GPIO MISC.; PinHeader_1x04_P2.54mm_Vertical
U1: AMS1117-3.3; TO-252-2
U2: ESP32-WROOM-32UE_16MB; ESP32-WROOM-32UE 16MB
U3: TPS2115APWR; PW8-M
U4, U7, U8: TLP2362TPR_E; TLP2362
U5: MAX31855KASA; SOIC-8_3.9x4.9mm_P1.27mm
U6: CP2102N-A02-GQFN24; QFN-24-1EP_4x4mm_P0.5mm_EP2.6x2.6mm

Connections:
+3.3V: C4.2, C5.2, C6.1, C9.2, C10.2, C11.1, J3.2, J4.2, J5.2, J6.2, JP1.3 (B), JP2.3 (B), JP3.3 (B), JP4.3 (B), R3.2, R4.2, R7.1, R8.2, R10.2, R11.2, R12.1, R22.1, R27.2, R28.2, R29.1, TP7.1, U2.2 (3V3), U3.7 (OUT), U5.4 (VCC), U6.5 (VIO), U6.6 (VDD), U6.7 (VREGIN)
+3.3VA: C7.2, J1.1, J1.3, J1.5, J1.7, R5.1, U3.6 (1N2)
+3.3VP: C2.1, C3.1, C8.2, R1.1, U1.2 (VO), U3.8 (1N1)
+5V: C13.1, C17.1, C18.1, J1.9, J1.11, R6.1, R13.1, R17.1, R18.1, U4.6 (VCC), U7.6 (VCC), U8.6 (VCC)
+5VA: C1.1, C14.1, D6.4 (K), J2.1 (VBUS), R2.1, U1.3 (VI)
/Auger: R16.1, U2.26 (IO4), U4.3 (CATHODE)
/DTR: Q1.4 (E2), R24.1, TP17.1, U6.23 (~DTR)
/EN: C20.1, Q1.6 (C1), R27.1, S2.2, TP16.1, U2.3 (EN)
/Fan: R23.1, U2.27 (IO16), U7.3 (CATHODE)
/I2C_SCL: J3.4, J4.4, J5.4, J6.4, R3.1, TP6.1, U2.36 (IO22)
/I2C_SDA: J3.3, J4.3, J5.3, J6.3, R4.1, TP5.1, U2.33 (IO21)
/IO0: C19.1, Q1.3 (C2), R28.1, S1.2, TP22.1, U2.25 (IO0)
/IO25: C15.1, R15.2, TP10.1, U2.10 (IO25)
/IO26: C16.1, R14.2, TP9.1, U2.11 (IO26)
/IO32: R25.1, TP18.1, TP27.4, U2.8 (IO32)
/IO33: MT1.2, R11.1, TP11.1, U2.9 (IO33)
/IO34: R33.1, TP25.1, TP27.2, U2.6 (IO34)
/IO35: R26.1, TP19.1, TP27.3, U2.7 (IO35)
/IO36: R32.1, TP24.1, TP27.1, U2.4 (SENSOR_VP)
/Ignitor: R31.1, U2.28 (IO17), U8.3 (CATHODE)
/MeatProbe+: J1.19, U2.14 (IO12)
/MeatProbe-: J1.20, U2.13 (IO14)
/Opto_Auger: J1.15, TP12.1, U4.5 (VO)
/Opto_Fan: J1.16, TP15.1, U7.5 (VO)
/Opto_Ignitor: J1.17, TP23.1, U8.5 (VO)
/Probe1+: C12.1, J1.13, U5.3 (T+)
/Probe1-: C12.2, J1.14, U5.2 (T-)
/RTS: Q1.1 (E1), R30.1, TP21.1, U6.19 (~RTS)
/RXD: R19.2, U6.20 (RXD)
/RXD0: R21.1, U2.34 (RXD0)
/SPI_CS: TP4.1, U2.29 (IO5), U5.6 (~CS)
/SPI_MISO: TP2.1, U2.31 (IO19), U5.7 (SO)
/SPI_MOSI: TP1.1, U2.37 (IO23)
/SPI_SCK: TP3.1, U2.30 (IO18), U5.5 (SCK)
/TXD: R21.2, U6.21 (TXD)
/TXD0: R19.1, U2.35 (TXD0)
/USB_DN: D6.3 (K), J2.2 (D-), U6.4 (D-)
/USB_DP: D6.2 (K), J2.3 (D+), U6.3 (D+)
GND: C1.2, C2.2, C3.2, C4.1, C5.1, C6.2, C7.1, C8.1, C9.1, C10.1, C11.2, C13.2, C14.2, C15.2, C16.2, C17.2, C18.2, C19.2, C20.2, D1.1 (K), D2.1 (K), D3.1 (K), D4.1 (K), D5.1 (K), D6.1 (A), J1.2, J1.4, J1.6, J1.8, J1.10, J1.12, J1.18, J2.5 (GND), J3.1, J4.1, J5.1, J6.1, JP1.1 (A), JP2.1 (A), JP3.1 (A), JP4.1 (A), MT1.1, MT1.COM, MT1.S1 (SHIELD), MT1.S2 (SHIELD), R8.1, R9.2, R16.2, R20.1, R23.2, R31.2, S1.1, S2.1, TP13.1, U1.1 (GND), U2.1 (GND), U2.15 (GND), U2.38 (GND), U2.39 (GND), U2.40 (GND), U2.41 (GND), U2.42 (GND), U2.43 (GND), U2.44 (GND), U2.45 (GND), U2.46 (GND), U2.47 (GND), U3.3 (D1), U3.5 (GND), U4.4 (GND), U5.1 (GND), U6.2 (GND), U6.25 (GND), U7.4 (GND), U8.4 (GND)
unnamed: D1.2 (A), R1.2
unnamed: D2.2 (A), R2.2
unnamed: D3.2 (A), R5.2
unnamed: D4.2 (A), R6.2
unnamed: D5.2 (A), R7.2
unnamed: JP1.2 (C), R25.2
unnamed: JP2.2 (C), R26.2
unnamed: JP3.2 (C), R32.2
unnamed: JP4.2 (C), R33.2
unnamed: MT1.A, R14.1, R18.2
unnamed: MT1.B, R15.1, R17.2
unnamed: Q1.2 (B1), R24.2
unnamed: Q1.5 (B2), R30.2
unnamed: R9.1, U3.4 (ILIM)
unnamed: R10.1, U6.9 (~RST)
unnamed: R12.2, TP8.1, U4.1 (ANODE)
unnamed: R13.2, R20.2, U6.8 (VBUS)
unnamed: R22.2, TP14.1, U7.1 (ANODE)
unnamed: R29.2, TP20.1, U8.1 (ANODE)
