dwynnychuk/SmartSmoker/PCB/HOPPER PCB/LightSensorPCB.kicad_pcb

## KiCad design PCB/HOPPER PCB/LightSensorPCB.kicad_pcb (2025-05-13)

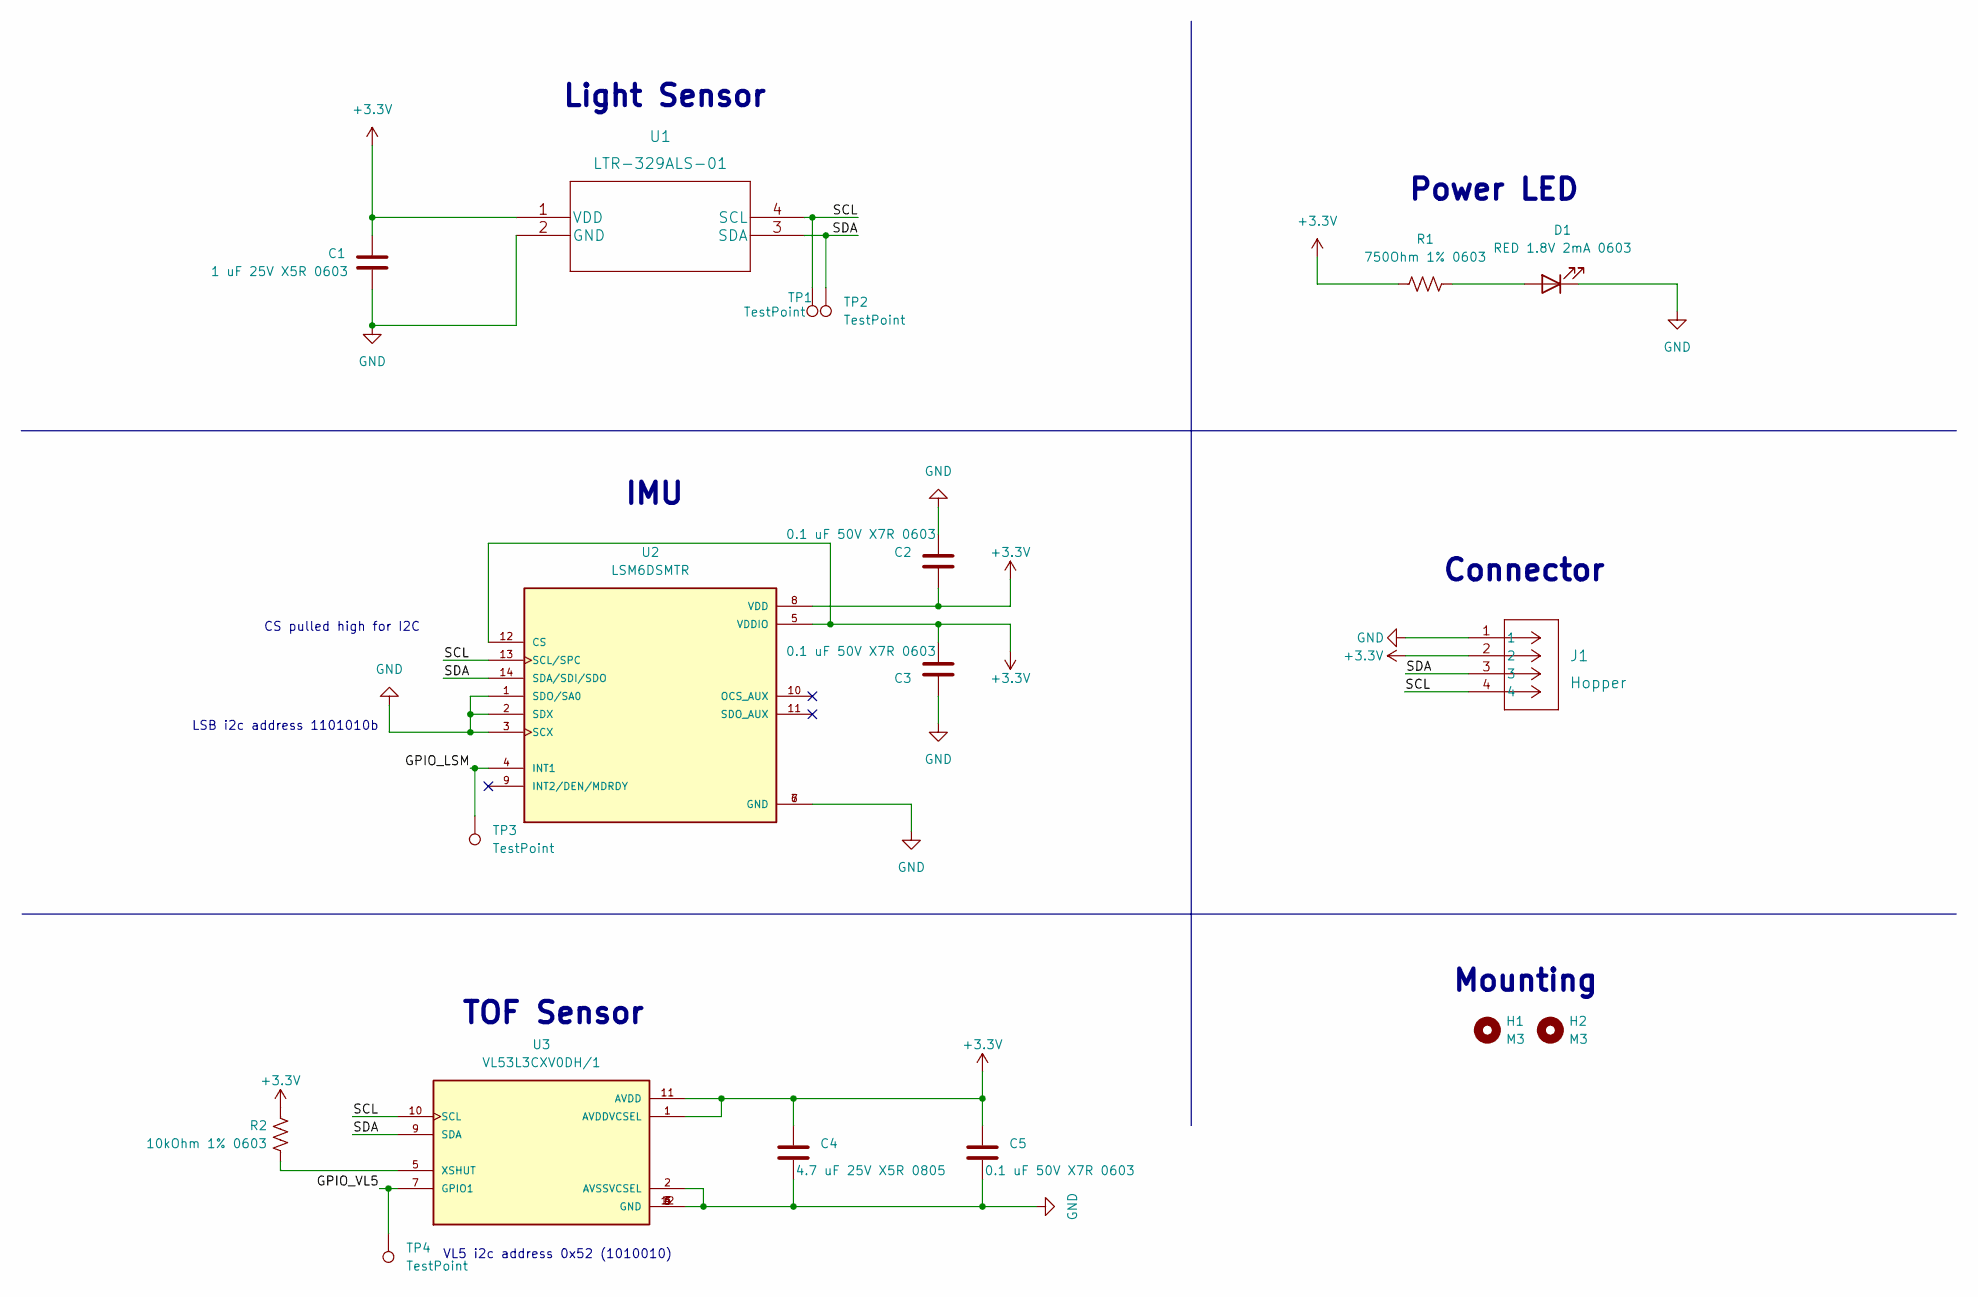
[picture p36: schematic LightSensorPCB.kicad_sch]

Parts:
C1: 1 uF 25V X5R 0603; C_0603_1608Metric; Manufacturer Part Number CL10A105KA8NNNC
C2, C3, C5: 0.1 uF 50V X7R 0603; C_0603_1608Metric; Manufacturer Part Number CL10B104KB8NNWC
C4: 4.7 uF 25V X5R 0805; C_0805_2012Metric; Manufacturer Part Number CL21A475KAQNNNE
D1: RED 1.8V 2mA 0603; LED_0603_1608Metric; Manufacturer Part Number CSL1901UW1
H1, H2: M3; MountingHole_3.2mm_M3_DIN965_Pad
J1: Hopper; PRT-14417; Manufacturer Part Number PRT-14417
R1: 750Ohm 1% 0603; R_0603_1608Metric; Manufacturer Part Number RC0603FR-07750RL
R2: 10kOhm 1% 0603; R_0603_1608Metric; Manufacturer Part Number RNCP0603FTD10K0
TP1, TP2, TP3, TP4: TestPoint; TestPoint_Pad_D1.0mm
U1: LTR-329ALS-01; Manufacturer Part Number LTR-329ALS-01
U2: LSM6DSMTR; PQFN50P300X250X86-14N; PARTREV Rev 7
U3: VL53L3CXV0DH/1; XDCR_VL53L3CXV0DH/1; PARTREV 2

Connections:
+3.3V: C1.1, C2.2, C3.2, C4.1, C5.1, J1.2, R1.2, R2.2, U1.1 (VDD), U2.5 (VDDIO), U2.8 (VDD), U2.12 (CS), U3.1 (AVDDVCSEL), U3.11 (AVDD)
/GPIO_LSM: TP3.1, U2.4 (INT1)
/GPIO_VL5: TP4.1, U3.7 (GPIO1)
/SCL: J1.4, TP1.1, U1.4 (SCL), U2.13 (SCL/SPC), U3.10 (SCL)
/SDA: J1.3, TP2.1, U1.3 (SDA), U2.14 (SDA/SDI/SDO), U3.9 (SDA)
GND: C1.2, C2.1, C3.1, C4.2, C5.2, D1.1 (K), J1.1, U1.2 (GND), U2.1 (SDO/SA0), U2.2 (SDX), U2.3 (SCX), U2.6 (GND), U2.7 (GND), U3.2 (AVSSVCSEL), U3.3 (GND), U3.4 (GND), U3.6 (GND), U3.12 (GND)
unnamed: D1.2 (A), R1.1
unnamed: R2.1, U3.5 (XSHUT)

Notes on the sheet:
Mounting
CS pulled high for I2C
TOF Sensor
Light Sensor
VL5 i2c address 0x52 (1010010)
LSB i2c address 1101010b
Connector
Power LED
IMU

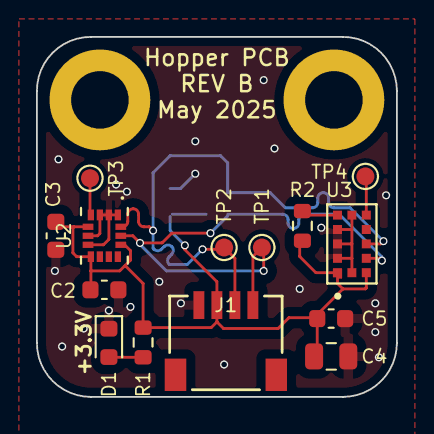
[picture p37: board LightSensorPCB.kicad_pcb from above]

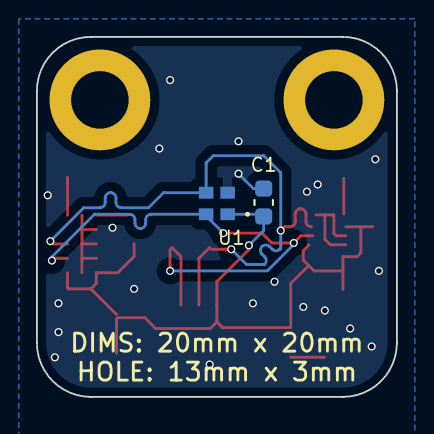
[picture p38: board LightSensorPCB.kicad_pcb from below]

Board: 2 copper layers, 20.0 x 20.0 mm, 18 parts (2 on the bottom side), 8 nets.
