dwynnychuk/SmartSmoker/PCB/Main PCB/REV A/Smart Smoker PCB.kicad_pcb

## KiCad design PCB/Main PCB/REV A/Smart Smoker PCB.kicad_pcb (2023-07-22, an earlier design)

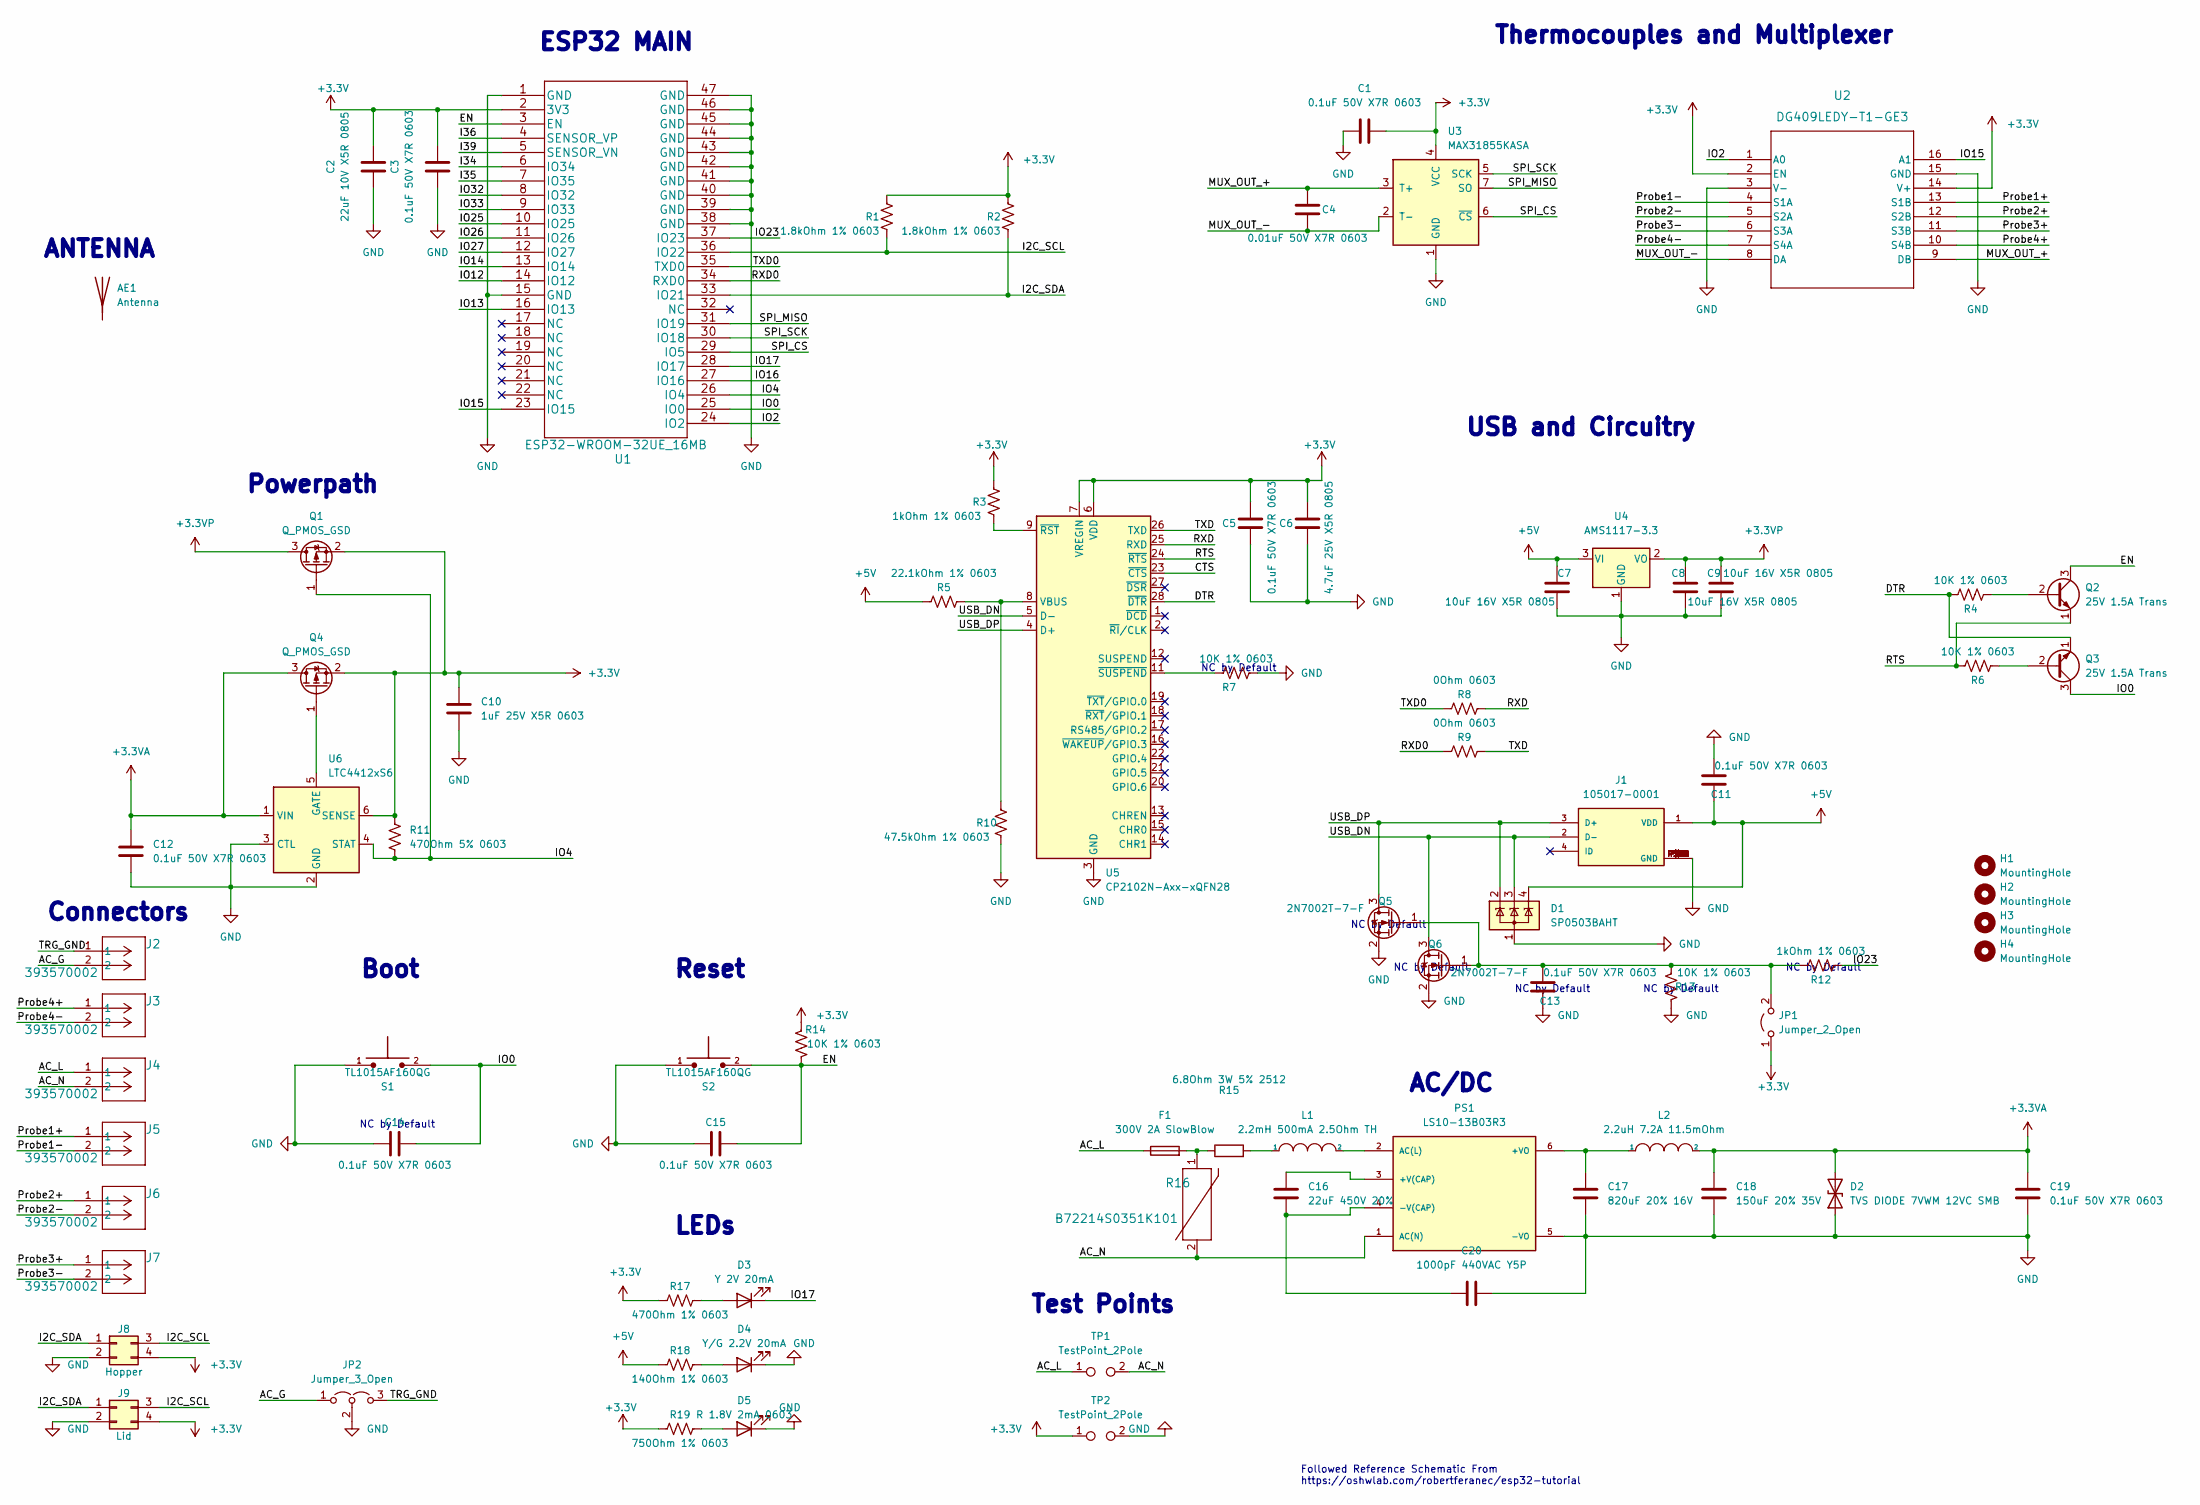
[picture p39: schematic Smart Smoker PCB.kicad_sch]

Parts:
AE1: Antenna; KiCad-Logo2_5mm_SilkScreen; Manufacturer Part Number W3921B0100
C1, C3, C5, C11, C12, C13, C14, C15, C19: 0.1uF 50V X7R 0603; C_0603_1608Metric; Manufacturer Part Number CL10B104KB8NNWC
C2: 22uF 10V X5R 0805; C_0805_2012Metric; Manufacturer Part Number CL21A226MPQNNNE
C4: 0.01uF 50V X7R 0603; C_0603_1608Metric; Manufacturer Part Number CL10B103KB8NNNC
C6: 4.7uF 25V X5R 0805; C_0805_2012Metric; Manufacturer Part Number CL21A475KAQNNNE
C7, C8, C9: 10uF 16V X5R 0805; C_0805_2012Metric; Manufacturer Part Number CL21A106KOQNNNE
C10: 1uF 25V X5R 0603; C_0603_1608Metric; Manufacturer Part Number CL10A105KA8NNNC
C16: 22uF 450V 20%; CP_Radial_D12.5mm_P5.00mm; Manufacturer Part Number UCY2W220MHD
C17: 820uF 20% 16V; CP_Radial_D10.0mm_P5.00mm; Manufacturer Part Number 860010375016
C18: 150uF 20% 35V; CP_Radial_D8.0mm_P3.50mm; Manufacturer Part Number 860020574010
C20: 1000pF 440VAC Y5P; C_Disc_D9.0mm_W5.0mm_P7.50mm; Manufacturer Part Number C927U102KZYDAA7317
D1: SP0503BAHT; SOT-143; Manufacturer Part Number SP0503BAHTG
D2: TVS DIODE 7VWM 12VC SMB; D_SMB; Manufacturer Part Number SMBJ7.0A
D3: Y 2V 20mA; LED_0603_1608Metric; Manufacturer Part Number 150060YS75000
D4: Y/G 2.2V 20mA; LED_0603_1608Metric; Manufacturer Part Number BL-HGE36D-AV-TRB
D5: R 1.8V 2mA 0603; LED_0603_1608Metric; Manufacturer Part Number CSL1901UW1
F1: 300V 2A SlowBlow; Fuse_Littelfuse_395Series; Manufacturer Part Number 36912000000
H1, H2, H3, H4: MountingHole; MountingHole_3.2mm_M3_DIN965_Pad
J1: 105017-0001; MOLEX_105017-0001; Manufacturer Part Number 1050170001
J2, J3, J4, J5, J6, J7: 393570002; CONN_393570002_MOL; Manufacturer Part Number 393570002
J8: Hopper; Molex_Micro-Fit_3.0_43045-0400_2x02_P3.00mm_Horizontal; Manufacturer Part Number 0430450400
J9: Lid; Molex_Micro-Fit_3.0_43045-0400_2x02_P3.00mm_Horizontal; Manufacturer Part Number 0430450400
JP1: Jumper_2_Open; PinHeader_1x02_P2.54mm_Vertical
JP2: Jumper_3_Open; SolderJumper-3_P1.3mm_Open_RoundedPad1.0x1.5mm
L1: 2.2mH 500mA 2.5Ohm TH; L_Radial_D10.5mm_P5.00mm_Abacron_AISR-01; Manufacturer Part Number 7687480222
L2: 2.2uH 7.2A 11.5mOhm; L_Taiyo-Yuden_NR-80xx; Manufacturer Part Number BWVS008080402R2M00
PS1: LS10-13B03R3; CONV_LS10-13B03R3; PARTREV 2020.12.14-A/5
Q1, Q4: Q_PMOS_GSD; VESM_TOS; Manufacturer Part Number SSM3J56MFV,L3F
Q2, Q3: 25V 1.5A Trans; SOT-23-3; Manufacturer Part Number SS8050-G
Q5, Q6: 2N7002T-7-F; SOT-23; Manufacturer Part Number 2N7002T-7-F
R1, R2: 1.8kOhm 1% 0603; R_0603_1608Metric; Manufacturer Part Number CRGCQ0603F1K8
R3, R12: 1kOhm 1% 0603; R_0603_1608Metric; Manufacturer Part Number RNCP0603FTD1K00
R4, R6, R7, R13, R14: 10K 1% 0603; R_0603_1608Metric; Manufacturer Part Number RNCP0603FTD10K0
R5: 22.1kOhm 1% 0603; R_0603_1608Metric; Manufacturer Part Number RC0603FR-0722K1L
R8, R9: 0Ohm 0603; R_0603_1608Metric; Manufacturer Part Number RMCF0603ZT0R00
R10: 47.5kOhm 1% 0603; R_0603_1608Metric; Manufacturer Part Number RC0603FR-0747K5L
R11: 470Ohm 5% 0603; R_0603_1608Metric; Manufacturer Part Number RC0603JR-07470RL
R15: 6.8Ohm 3W 5% 2512; R_Box_L8.4mm_W2.5mm_P5.08mm; Manufacturer Part Number AC03000006808JAC00
R16: B72214S0351K101; VARS_B72214S_15P5X5P6-7P5-2P2_TDK; Manufacturer Part Number B72214S0351K101
R17: 470Ohm 1% 0603; R_0603_1608Metric; Manufacturer Part Number RC0603FR-13470RL
R18: 140Ohm 1% 0603; R_0603_1608Metric; Manufacturer Part Number RC0603FR-07140RL
R19: 750Ohm 1% 0603; R_0603_1608Metric; Manufacturer Part Number RC0603FR-07750RL
S1, S2: TL1015AF160QG; SW_TL1015AF160QG; PARTREV F
TP1, TP2: TestPoint_2Pole; TestPoint_2Pads_Pitch5.08mm_Drill1.3mm
U1: ESP32-WROOM-32UE_16MB; ESP32-WROOM-32UE 16MB; Manufacturer Part Number ESP32-WROOM-32UE-N4
U2: DG409LEDY-T1-GE3; SOIC16_NARROW_VIS; Manufacturer Part Number DG409LEDY-T1-GE3
U3: MAX31855KASA; SOIC-8_3.9x4.9mm_P1.27mm; Manufacturer Part Number MAX31855KASA+T
U4: AMS1117-3.3; TO-252-3_TabPin2; Manufacturer Part Number AMS1117CD-3.3
U5: CP2102N-Axx-xQFN28; QFN-28-1EP_5x5mm_P0.5mm_EP3.35x3.35mm
U6: LTC4412xS6; TSOT-23-6; Manufacturer Part Number LTC4412ES6#TRMPBF

Connections:
+3.3V: C1.1, C2.2, C3.2, C5.2, C6.2, C10.2, J8.4, J9.4, JP1.1 (A), Q1.2 (S), Q4.2 (S), R1.2, R2.2, R3.2, R11.2, R14.2, R17.1, R19.1, TP2.1, U1.2 (3V3), U2.2 (EN), U2.14 (V+), U3.4 (VCC), U5.6 (VDD), U5.7 (VREGIN), U6.6 (SENSE)
+3.3VA: C12.1, C18.1, C19.1, D2.2 (A2), L2.2, Q4.3 (D), U6.1 (VIN)
+3.3VP: C8.1, C9.1, Q1.3 (D), U4.2 (VO)
+5V: C7.1, C11.1, D1.4 (K), J1.1 (VDD), R5.1, R18.1, U4.3 (VI)
/AC_G: J2.2, JP2.1 (A)
/AC_L: F1.1, J4.1, TP1.1
/AC_N: J4.2, PS1.1 (AC(N)), R16.2, TP1.2
/CTS: U5.23 (~CTS)
/DTR: Q3.1 (E), R4.1, U5.28 (~DTR)
/EN: C15.1, Q2.3 (C), R14.1, S2.2, U1.3 (EN)
/I2C_SCL: J8.3, J9.3, R1.1, U1.36 (IO22)
/I2C_SDA: J8.1, J9.1, R2.1, U1.33 (IO21)
/I34: U1.6 (IO34)
/I35: U1.7 (IO35)
/I36: U1.4 (SENSOR_VP)
/I39: U1.5 (SENSOR_VN)
/IO0: C14.2, Q3.3 (C), S1.2, U1.25 (IO0)
/IO2: U1.24 (IO2), U2.1 (A0)
/IO4: Q1.1 (G), R11.1, U1.26 (IO4), U6.4 (STAT)
/IO12: U1.14 (IO12)
/IO13: U1.16 (IO13)
/IO14: U1.13 (IO14)
/IO15: U1.23 (IO15), U2.16 (A1)
/IO16: U1.27 (IO16)
/IO17: D3.1 (K), U1.28 (IO17)
/IO23: R12.1, U1.37 (IO23)
/IO25: U1.10 (IO25)
/IO26: U1.11 (IO26)
/IO27: U1.12 (IO27)
/IO32: U1.8 (IO32)
/IO33: U1.9 (IO33)
/MUX_OUT_+: C4.1, U2.9 (DB), U3.3 (T+)
/MUX_OUT_-: C4.2, U2.8 (DA), U3.2 (T-)
/Probe1+: J5.1, U2.13 (S1B)
/Probe1-: J5.2, U2.4 (S1A)
/Probe2+: J6.1, U2.12 (S2B)
/Probe2-: J6.2, U2.5 (S2A)
/Probe3+: J7.1, U2.11 (S3B)
/Probe3-: J7.2, U2.6 (S3A)
/Probe4+: J3.1, U2.10 (S4B)
/Probe4-: J3.2, U2.7 (S4A)
/RTS: Q2.1 (E), R6.1, U5.24 (~RTS)
/RXD: R8.2, U5.25 (RXD)
/RXD0: R9.1, U1.34 (RXD0)
/SPI_CS: U1.29 (IO5), U3.6 (~CS)
/SPI_MISO: U1.31 (IO19), U3.7 (SO)
/SPI_SCK: U1.30 (IO18), U3.5 (SCK)
/TRG_GND: J2.1, JP2.3 (B)
/TXD: R9.2, U5.26 (TXD)
/TXD0: R8.1, U1.35 (TXD0)
/USB_DN: D1.3 (K), J1.2 (D-), Q6.3 (D), U5.5 (D-)
/USB_DP: D1.2 (K), J1.3 (D+), Q5.3 (D), U5.4 (D+)
GND: C1.2, C2.1, C3.1, C5.1, C6.1, C7.2, C8.2, C9.2, C10.1, C11.2, C12.2, C13.1, C14.1, C15.2, C17.2, C18.2, C19.2, C20.2, D1.1 (A), D2.1 (A1), D4.1 (K), D5.1 (K), J1.5 (GND), J1.P$1 (GND), J1.P$2 (GND), J1.P$8 (GND), J1.P$9 (GND), J1.P$10 (GND), J1.P$11 (GND), J1.P$12 (GND), J1.P$13 (GND), J8.2, J9.2, JP2.2 (C), PS1.5 (-VO), Q5.2 (S), Q6.2 (S), R7.1, R10.1, R13.2, S1.1, S2.1, TP2.2, U1.1 (GND), U1.15 (GND), U1.38 (GND), U1.39 (GND), U1.40 (GND), U1.41 (GND), U1.42 (GND), U1.43 (GND), U1.44 (GND), U1.45 (GND), U1.46 (GND), U1.47 (GND), U2.3 (V-), U2.15 (GND), U3.1 (GND), U4.1 (GND), U5.3 (GND), U5.29 (GND), U6.2 (GND), U6.3 (CTL)
unnamed: C13.2, JP1.2 (B), Q5.1 (G), Q6.1 (G), R12.2, R13.1
unnamed: C16.1, PS1.3 (+V(CAP))
unnamed: C16.2, C20.1, PS1.4 (-V(CAP))
unnamed: C17.1, L2.1, PS1.6 (+VO)
unnamed: D3.2 (A), R17.2
unnamed: D4.2 (A), R18.2
unnamed: D5.2 (A), R19.2
unnamed: F1.2, R15.1, R16.1
unnamed: L1.1, R15.2
unnamed: L1.2, PS1.2 (AC(L))
unnamed: Q2.2 (B), R4.2
unnamed: Q3.2 (B), R6.2
unnamed: Q4.1 (G), U6.5 (GATE)
unnamed: R3.1, U5.9 (~RST)
unnamed: R7.2, U5.11 (~SUSPEND)
unnamed: R5.2, R10.2, U5.8 (VBUS)

Notes on the sheet:
Powerpath
Reset
USB and Circuitry
Connectors
LEDs
Boot
Thermocouples and Multiplexer
Test Points
NC by Default
Followed Reference Schematic From https://oshwlab.com/robertferanec/esp32-tutorial
ANTENNA
ESP32 MAIN
AC/DC

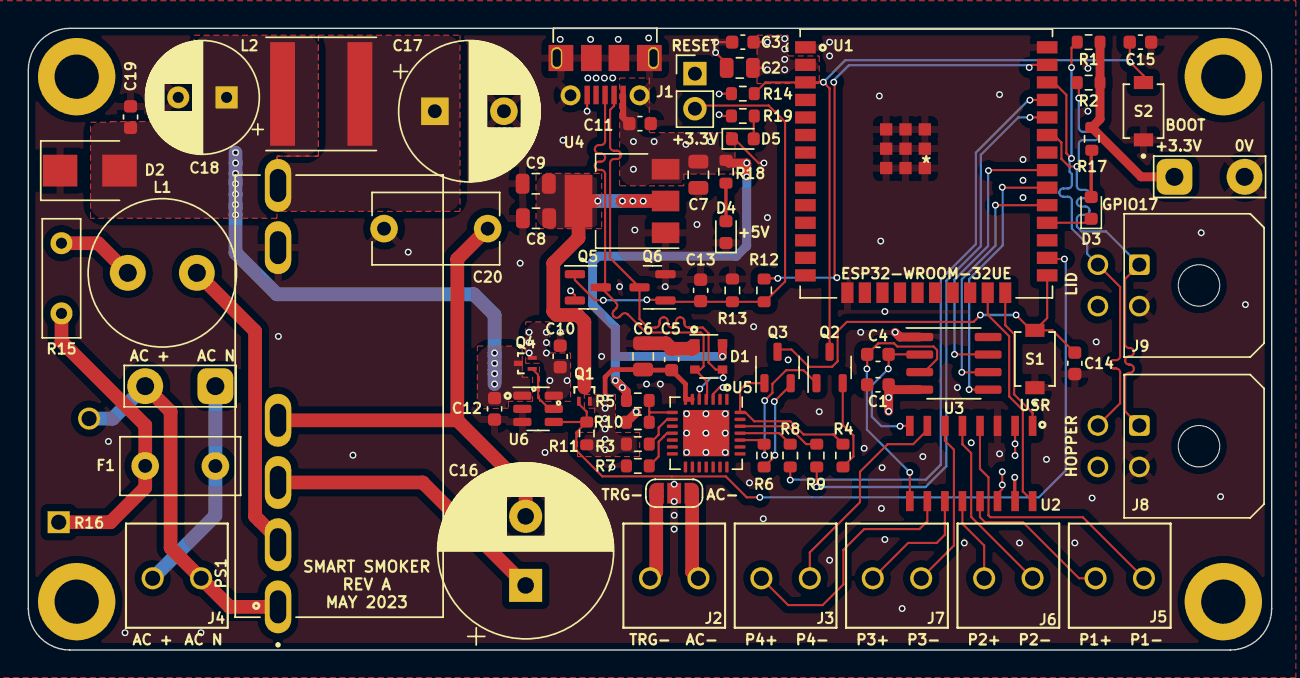
[picture p40: board Smart Smoker PCB.kicad_pcb from above]

Board: 4 copper layers, 90.0 x 45.0 mm, 80 parts (1 on the bottom side), 55 nets.
