dwynnychuk/SmartSmoker/PCB/LID PCB/LIDPCB.kicad_pcb

## KiCad design PCB/LID PCB/LIDPCB.kicad_pcb (2023-06-02)

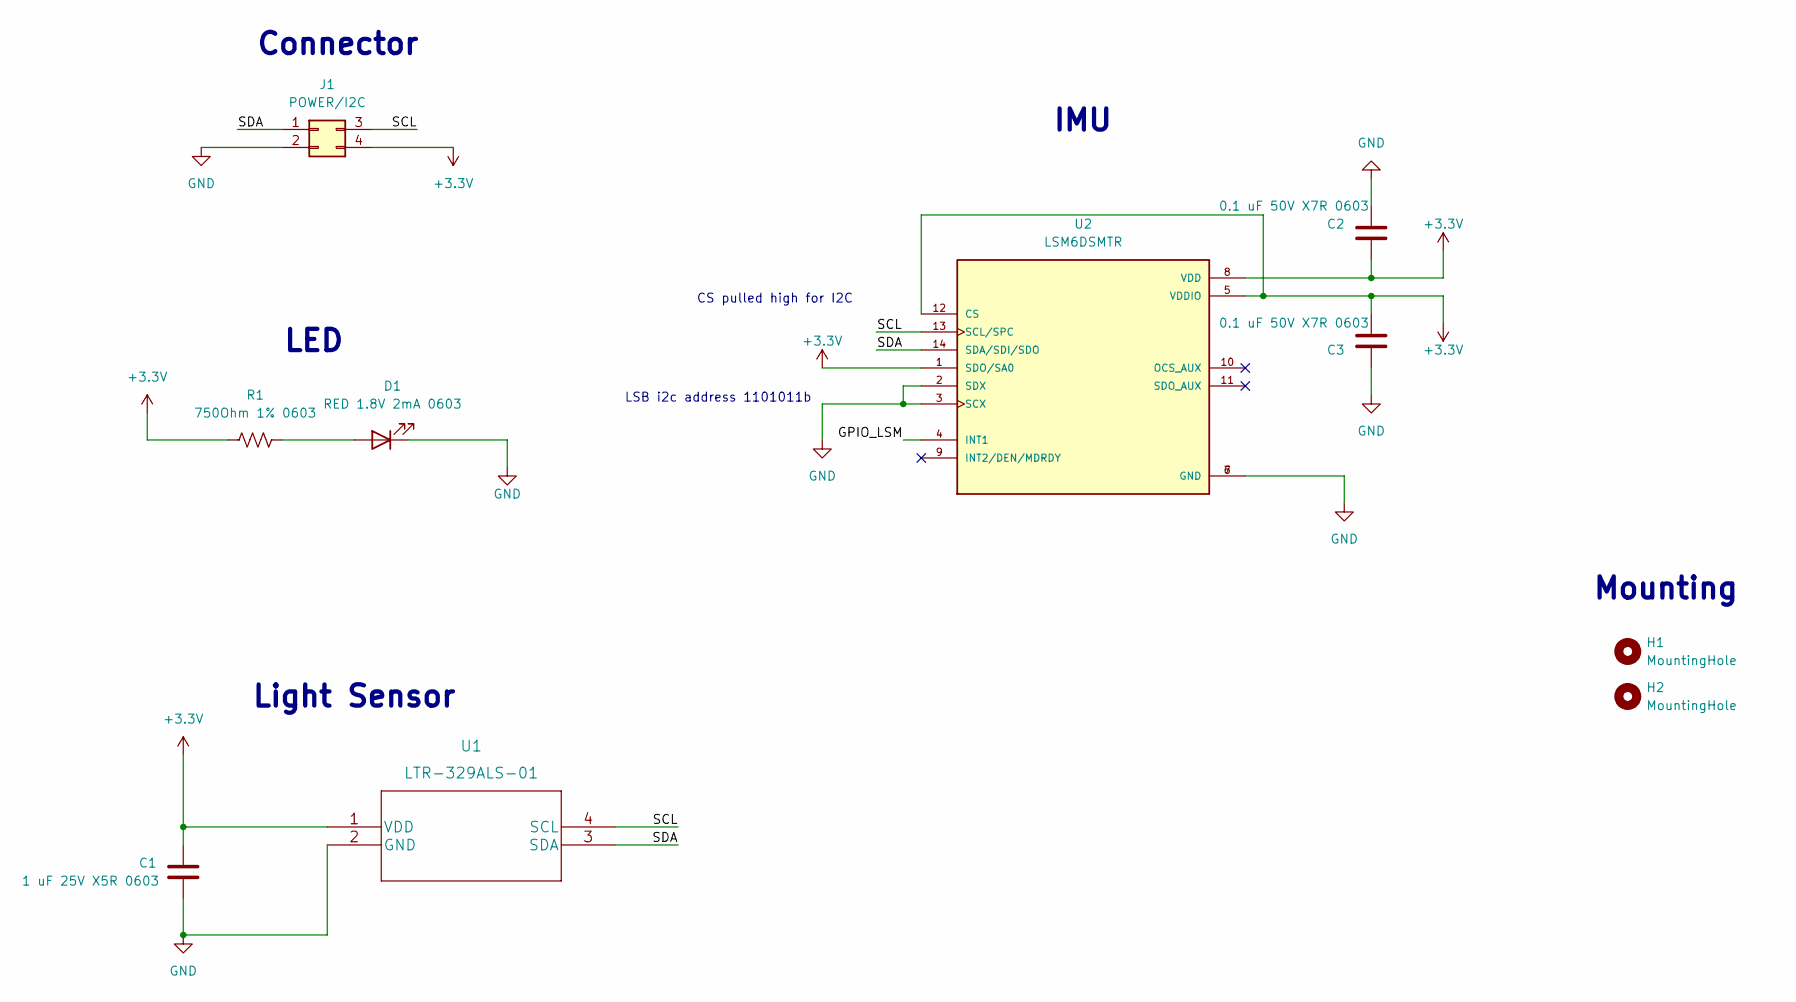
[picture p41: schematic LIDPCB.kicad_sch]

Parts:
C1: 1 uF 25V X5R 0603; C_0603_1608Metric; Manufacturer Part Number CL10A105KA8NNNC
C2, C3: 0.1 uF 50V X7R 0603; C_0603_1608Metric; Manufacturer Part Number CL10B104KB8NNWC
D1: RED 1.8V 2mA 0603; LED_0603_1608Metric; Manufacturer Part Number CSL1901UW1
H1, H2: MountingHole; MountingHole_3.2mm_M3_DIN965_Pad
J1: POWER/I2C; Molex_Micro-Fit_3.0_43045-0400_2x02_P3.00mm_Horizontal; Manufacturer Part Number 0430450400
R1: 750Ohm 1% 0603; R_0603_1608Metric; Manufacturer Part Number RC0603FR-07750RL
U1: LTR-329ALS-01; Manufacturer Part Number LTR-329ALS-01
U2: LSM6DSMTR; PQFN50P300X250X86-14N; PARTREV Rev 7

Connections:
+3.3V: C1.1, C2.2, C3.2, J1.4, R1.2, U1.1 (VDD), U2.1 (SDO/SA0), U2.5 (VDDIO), U2.8 (VDD), U2.12 (CS)
/GPIO_LSM: U2.4 (INT1)
/SCL: J1.3, U1.4 (SCL), U2.13 (SCL/SPC)
/SDA: J1.1, U1.3 (SDA), U2.14 (SDA/SDI/SDO)
GND: C1.2, C2.1, C3.1, D1.1 (K), J1.2, U1.2 (GND), U2.2 (SDX), U2.3 (SCX), U2.6 (GND), U2.7 (GND)
unnamed: D1.2 (A), R1.1

Notes on the sheet:
IMU
LSB i2c address 1101011b
CS pulled high for I2C
Connector
Mounting
LED
Light Sensor

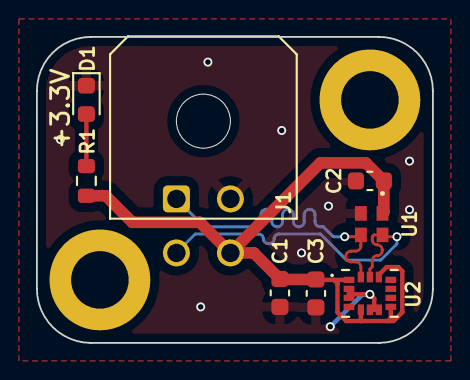
[picture p42: board LIDPCB.kicad_pcb from above]

Board: 2 copper layers, 22.0 x 17.0 mm, 10 parts (0 on the bottom side), 5 nets.
