dwynnychuk/SmartSmoker/ESP32Code/src/DisplayController.cpp

#include "DisplayController.h"
#include "StateMachine.h"

DisplayController::DisplayController()
    : _display(SCREEN_WIDTH, SCREEN_HEIGHT, &Wire, OLED_RESET) {}

bool DisplayController::begin() {
    if (!_display.begin(SSD1306_SWITCHCAPVCC, OLED_ADDR)) {
        return false;
    }
    _display.clearDisplay();
    _display.setTextColor(SSD1306_WHITE);
    _display.display();
    return true;
}

void DisplayController::render(GrillState _state, const Telemetry& data, float _setTemp, ErrorCode _error) {
    _display.clearDisplay();

    switch(_state) {
        case GrillState::IDLE:
        _drawHeader("IDLE", _setTemp);
        _drawBigTemp(data.tempRTD);
        _drawFooter("Push to Ignite", "");
        break;

        case GrillState::IGNITION:
        _drawHeader("IGNITING", _setTemp);
        _drawBigTemp(data.tempRTD);
        _drawFooter("Warming Up", "");
        break;

        case GrillState::PREHEAT:
        _drawHeader("IGNITING", _setTemp);
        _drawBigTemp(data.tempRTD);
        _drawFooter("Warming Up", "");
        break;

        case GrillState::TEMP_HOLD:
        _drawHeader("COOKING", _setTemp);
        _drawBigTemp(data.tempRTD);
        _drawFooter("Auger: ", "100%");
        break;

        case GrillState::LID_OPEN:
        _drawHeader("LID OPEN", _setTemp);
        _drawBigTemp(data.tempRTD);
        _drawFooter("Close Lid Soon", "");
        break;

        case GrillState::COOLDOWN:
        _drawHeader("SHUTDOWN", _setTemp);
        _drawBigTemp(data.tempRTD);
        _drawFooter("Cooling Down", "");
        break;

        case GrillState::ERROR:
        _drawAlarm(_error);
        break;
    }

    _display.display();

    return;
}

void DisplayController::_drawHeader(const char* label, float setTemp) {
    _display.setTextSize(1);
    _display.setCursor(0,0);
    _display.print(label);

    _display.setCursor(72,0);
    _display.print("Set:");
    _display.print((int)setTemp);
    _display.print((char)247);  // Degrees
}

void DisplayController::_drawBigTemp(float temp) {
    _display.setTextSize(3);
    _display.setCursor(24, 20);
    _display.print((int)temp);
    _display.print((char)247);  // degrees
}

void DisplayController::_drawFooter(const char* left, const char* right) {
    _display.setTextSize(1);
    _display.setCursor(0, 56);
    _display.print(left);
    _display.setCursor(80, 56);
    _display.print(right);
}

void DisplayController::_drawAlarm(ErrorCode error) {
    _display.setTextSize(1);
    _display.setCursor(0,0);
    _display.print("ERROR");
    
    _display.setTextSize(2);
    _display.setCursor(0,20);
    
    switch(error) {
        case ErrorCode::IGNITION_TIMEOUT:
        _display.print("Ignition Timeout");
        break;

        case ErrorCode::OVERTEMP:
        _display.print("High Temperature");
        break;

        case ErrorCode::UNDERTEMP:
        _display.print("Low Temperature");
        break;

        case ErrorCode::SENSOR_FAULT:
        _display.print("Sensor Error");
        break;

        default:
        _display.print("Unknown Error");
        break;
    }

    _display.setTextSize(1);
    _display.setCursor(0,56);
    _display.print("Push to Clear");
}
