dwynnychuk/SmartSmoker/ESP32Code/src/LightSensor.cpp

#include "LightSensor.h"

LightSensor::LightSensor(uint8_t address)
    : addr(address), value(0) {}

uint8_t LightSensor::readReg(uint8_t reg) {
    Wire.beginTransmission(addr);
    Wire.write(reg);
    Wire.endTransmission();

    Wire.requestFrom(addr, (uint8_t)1);

    if (Wire.available()) {
        return Wire.read();
    }

    return 0;
}

bool LightSensor::begin() {
    Wire.beginTransmission(addr);
    Wire.write(0x80);       // Control Register
    Wire.write(0x0D);       // 8x Gain
    return Wire.endTransmission() == 0;
}

void LightSensor::update() {
    uint8_t lsb = readReg(0x8A);    // low byte
    uint8_t msb = readReg(0x8B);    // high byte

    value = (msb << 8) | lsb;
}

uint16_t LightSensor::getRawLux() {
    return value;
}
