dwynnychuk/SmartSmoker/(commit log)

2023-02-03 Added PCB Files
    [Smart Smoker PCB.kicad_pcb, Smart Smoker PCB.kicad_sch]
2023-02-05 Added C++ code
    [Smart Smoker PCB.kicad_pcb, Smart Smoker PCB.kicad_sch]
2023-02-05 Accelerometer Code
2023-02-06 Accelerometer reading values, seems incorrect. Refactoring
2023-02-06 Accelerometer refactored, need to calibrate
2023-02-06 Accelerometer working, issue with calibration
    [main.cpp]
2023-02-08 Calibration not working and deleted
    [main.cpp]
2023-02-11 SPI ambient temp integration
2023-02-11 functional thermocouple with I2C
2023-02-12 PCB for light sensor started
    [LightSensorPCB.kicad_pcb, LightSensorPCB.kicad_sch]
2023-02-14 Light detection PCB
    [LTR-329ALS-01_LTO.step, LightSensorPCB.kicad_sch]
2023-02-15 Light detection PCB finished
    [LightSensorPCB-B_Cu.gbl, LightSensorPCB-B_Mask.gbs, LightSensorPCB-B_Paste.gbp, LightSensorPCB-B_Silkscreen.gbo, LightSensorPCB-Edge_Cuts.gm1, LightSensorPCB-F_Cu.gtl, LightSensorPCB-F_Mask.gts, LightSensorPCB-F_Paste.gtp]
2023-02-16 Added ESP32 board pcb files
    [Smart Smoker PCB.kicad_pcb, Smart Smoker PCB.kicad_sch]
2023-05-22 Significant PCB progress
    [LTR-329ALS-01_LTO.step, LightSensorPCB.kicad_pcb, LightSensorPCB.kicad_sch, Smart Smoker PCB.kicad_pcb, Smart Smoker PCB.kicad_sch]
2023-05-25 PCB layout done
    [Smart Smoker PCB.kicad_pcb, Smart Smoker PCB.kicad_sch]
2023-05-26 46 traces left for routing main pcb
    [Smart Smoker PCB.kicad_pcb]
2023-05-27 Main PCB ready for review
    [Smart Smoker PCB.kicad_pcb, Smart Smoker PCB.kicad_sch]
2023-05-28 LID PCB ready for review
    [105017-0001.step, 393570002.stp, 430450400--3DModel-STEP-1.STEP, ESP32-WROOM-32UE-N4--3DModel-STEP-269445.STEP, LIDPCB.kicad_pcb, LIDPCB.kicad_sch, LSM6DSMTR--3DModel-STEP-56544.STEP, LSM6DSMTR.step]
2023-05-28 Main pcb reviewed
    [LIDPCB.kicad_pcb, LIDPCB.kicad_sch, LightSensorPCB.kicad_pcb, LightSensorPCB.kicad_sch, Smart Smoker PCB.kicad_pcb, Smart Smoker PCB.kicad_sch]
2023-05-30 3x PCB ready for gerberization
    [LIDPCB.kicad_pcb, LIDPCB.kicad_sch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]
2023-05-30 3x PCB gerberd
    [LIDPCB.kicad_pcb, LightSensorPCB.kicad_pcb, Smart Smoker PCB.kicad_pcb]
2023-06-01 MOV added to PCB1
    [Smart Smoker PCB.kicad_pcb, Smart Smoker PCB.kicad_sch]
2023-06-02 3x PCB ordered
    [LIDPCB.kicad_pcb, LightSensorPCB.kicad_pcb, LightSensorPCB.kicad_sch, Smart Smoker PCB.kicad_pcb, Smart Smoker PCB.kicad_sch]
2023-07-22 Test on custom pcb initial
    [Smart Smoker PCB.kicad_pcb, Smart Smoker PCB.kicad_sch]
2023-07-22 blink works on custom pcb
2023-07-22 error in temp reading
    [main.cpp]
2023-07-23 functional reading from LTR light sensor
2023-07-23 LTR sensor cleaned up
2023-07-29 add ToF library
    [LIDPCB-B_Cu.gbl, LIDPCB-B_Mask.gbs, LIDPCB-B_Paste.gbp, LIDPCB-B_Silkscreen.gbo, LIDPCB-Edge_Cuts.gm1, LIDPCB-F_Cu.gtl, LIDPCB-F_Mask.gts, LIDPCB-F_Paste.gtp]
2023-07-29 Temperature sensing working with new method, using MAX library. MUX stuck on OUT3, need to troubleshoot. Logic analizer reading consistent reading across mux
    [main.cpp]
2023-07-29 cleanup of temperature code
2023-07-29 IMU works for hopper
2023-07-29 LID imu functional, issue with address for I2C forgetting read/write bit
    [main.cpp]
2023-07-29 Both IMUs, light sensor, and temperature sensor functional
2023-08-01 Started Hardware Rev B
    [LightSensorPCB-B_Cu.gbl, LightSensorPCB-B_Mask.gbs, LightSensorPCB-B_Paste.gbp, LightSensorPCB-B_Silkscreen.gbo, LightSensorPCB-Edge_Cuts.gm1, LightSensorPCB-F_Cu.gtl, LightSensorPCB-F_Mask.gts, LightSensorPCB-F_Paste.gtp]
2023-08-01 Added suggestions to Hardware Rev B
    [Smart Smoker PCB.kicad_sch]
2023-08-02 Hardware Rev B in progress
    [Smart Smoker PCB.kicad_sch]
2023-08-06 Hardware Rev B development
    [Smart Smoker PCB.kicad_sch]
2023-08-06 Hardware Rev B development - missing relays
    [Smart Smoker PCB.kicad_sch]
2023-08-07 Hardware Rev B development - found 2/3 SSRs
    [ASMB-KTF0-0A306.step, MEM2051-00-195-00-A--3DModel-STEP-1.STEP, PEC11R-4215F-S0024.step, RR511D1121.step]
2023-08-09 Hardware Rev B development - 3/3 SSRs sourced
    [Smart Smoker PCB.kicad_sch]
2023-08-10 Hardware Rev B development Relays and Rotary Encoder
    [Smart Smoker PCB.kicad_pcb, Smart Smoker PCB.kicad_sch]
2023-08-15 Rev B Hardware - organization of schematic and initial layout for board sizing
    [Smart Smoker PCB.kicad_pcb, Smart Smoker PCB.kicad_sch, power.kicad_sch]
2023-11-19 Component changes, new relays
    [Smart Smoker PCB.kicad_sch, loads.kicad_sch, power.kicad_sch]
2023-11-19 Component changes, new ignitor relay - need to do supporting circuity
    [SIP4_CPC1966Y_LTF.step, Smart Smoker PCB.kicad_sch, loads.kicad_sch]
2023-11-19 Relay circuitry complete - snubber added to inductive loads
    [Smart Smoker PCB.kicad_sch, loads.kicad_sch]
2024-03-06 Rid power path selector, moving to or diode system for power path selection
    [1051330001.stp, DCK0006A.stp, Smart Smoker PCB.kicad_pcb, Smart Smoker PCB.kicad_sch, loads.kicad_sch, power.kicad_sch]
2024-03-06 Powerpath development
    [Smart Smoker PCB.kicad_sch, power.kicad_sch]
2024-03-07 Moved from ORing diodes to power MUX as per TI recommendations
    [Smart Smoker PCB.kicad_sch, TPS2115APWR.step, loads.kicad_sch, power.kicad_sch]
2024-03-08 Power Mux and rest of power systems designed and ready for layout
    [Smart Smoker PCB.kicad_sch, power.kicad_sch]
2024-03-08 Changed out connectors to AJ connectors
    [MJ-3502.step, Smart Smoker PCB.kicad_sch]
2024-03-08 Changed rotary encoder to incremental, nearly done design on rotary encoder
    [PEC11R-4220K-S0024.STEP, Smart Smoker PCB.kicad_sch, loads.kicad_sch, power.kicad_sch]
2024-03-12 Rotary dial complete
    [Smart Smoker PCB.kicad_sch]
2024-03-13 SD card complete. All gpio full
    [DM3CS-SF.stp, Smart Smoker PCB.kicad_sch, loads.kicad_sch, power.kicad_sch]
2024-03-31 Begin layout Rev B PCB
    [Smart Smoker PCB.kicad_pcb, Smart Smoker PCB.kicad_sch, loads.kicad_sch, power.kicad_sch]
2024-09-08 Add gui
    [Smart Smoker PCB.kicad_sch]
2024-09-11 added connection frame to gui
2024-09-18 Logging buttons and functionality working
2024-09-30 Fix logging stop button
    [gui.py]
2025-03-09 PCB schematic updates, added 5V power supply
    [PAN_ALD_PAN.step, Smart Smoker PCB.kicad_sch, loads.kicad_sch, power.kicad_sch]
2025-03-09 PCB schematic updates, Modified and fixed all power sheets
    [PW0008A.stp, Smart Smoker PCB.kicad_sch, loads.kicad_sch, power.kicad_sch]
2025-03-11 PCB schematic updates, Added optoisolators for relay circuits
    [5pin SO6.step, Smart Smoker PCB.kicad_sch, loads.kicad_sch]
2025-03-11 PCB schematic updates, Find mosfet for relay on circuit
    [Smart Smoker PCB.kicad_pcb, Smart Smoker PCB.kicad_sch, loads.kicad_sch, power.kicad_sch]
2025-03-14 PCB schematic updates, Relay Circuits Completed
    [RB521S30T1G.step, Smart Smoker PCB.kicad_sch, loads.kicad_sch]
2025-03-16 PCB schematic updates, Thermocouple connector sourced and updated
    [Smart Smoker PCB.kicad_pcb, Smart Smoker PCB.kicad_sch, loads.kicad_sch]
2025-03-16 PCB schematic updates, Screen and Probe jack updates
    [Smart Smoker PCB.kicad_sch, loads.kicad_sch]
2025-03-16 PCB schematic updates, Rotary Encoder Updates
    [Smart Smoker PCB.kicad_sch]
2025-03-17 PCB schematic updates, Change to smaller thermocouple mux
    [SN74LVC1G3157DBVR.stp, Smart Smoker PCB.kicad_sch, loads.kicad_sch, power.kicad_sch]
2025-03-19 PCB schematic updates, Reboot circuit fixed
    [STM811SW16F.step, Smart Smoker PCB.kicad_pcb, Smart Smoker PCB.kicad_sch, loads.kicad_sch, power.kicad_sch]
2025-03-19 PCB schematic updates, Changed transistor on reboot to double
    [Smart Smoker PCB.kicad_sch, loads.kicad_sch, power.kicad_sch]
2025-03-19 PCB schematic updates, Cleanup and Add LEDS
    [Smart Smoker PCB.kicad_sch]
2025-03-20 PCB schematic updates, Fix LED part number and clean up schematic. Added test points
    [Smart Smoker PCB.kicad_pcb, Smart Smoker PCB.kicad_sch]
2025-03-30 PCB schematic updates, Delete lid connections, add qwiic connectors
    [PRT-14417.STEP, Smart Smoker PCB.kicad_pcb, Smart Smoker PCB.kicad_sch]
2025-03-30 PCB Layout - Begin Grouping of main PCB
    [Smart Smoker PCB.kicad_pcb, Smart Smoker PCB.kicad_sch]
2025-03-31 PCB Layout - Continue Grouping layout
    [Smart Smoker PCB.kicad_pcb, Smart Smoker PCB.kicad_sch]
2025-03-31 PCB Layout - Continue Grouping layout for relays
    [Smart Smoker PCB.kicad_pcb]
2025-04-09 PCB Layout - Set board outline and organize
    [Smart Smoker PCB.kicad_pcb]
2025-04-10 PCB Layout - Modify board layout and get relay circuit organized
    [Smart Smoker PCB.kicad_pcb, Smart Smoker PCB.kicad_sch]
2025-04-18 PCB Layout - Fix Usb footprint
    [Smart Smoker PCB.kicad_pcb]
2025-04-19 PCB Layout - Work on rotary footprint, change usb to horizontal
    [Smart Smoker PCB.kicad_pcb, Smart Smoker PCB.kicad_sch]
2025-04-20 PCB Layout
2025-04-20 PCB - Changed to Analog and Digital Board to solve interface headaches
    [AnalogPCB.kicad_pcb, AnalogPCB.kicad_sch, DF12NB_4.0_-20DP-0.5V_51_.step, DF12NC-20DS-0.5V_51_.step, DigitalPCB.kicad_pcb, DigitalPCB.kicad_sch, Smart Smoker PCB.kicad_pcb, loads.kicad_sch]
2025-04-21 PCB - Rough Analog Layout
    [AnalogPCB.kicad_pcb, AnalogPCB.kicad_sch, DigitalPCB.kicad_pcb, DigitalPCB.kicad_sch, Same_Sky_SJ3-35053D.step]
2025-04-21 PCB - Rough Analog Layout and probe jack change to RTD
    [AnalogPCB.kicad_pcb, AnalogPCB.kicad_sch]
2025-04-23 PCB - Lay out analog led and power filtering
    [AnalogPCB.kicad_pcb]
2025-04-23 PCB - Lay out analog mostly complete. cad added
    [AnalogPCB.kicad_pcb, power_supply_irm-10-3_3.stp]
2025-05-04 PCB - Grouping for digital layout
    [AnalogPCB.kicad_pcb, AnalogPCB.kicad_sch, DigitalPCB.kicad_sch]
2025-05-05 PCB - Digital layout nearly complete
    [DigitalPCB.kicad_pcb]
2025-05-05 PCB - Digital layout complete
    [DigitalPCB.kicad_pcb]
2025-05-08 PCB - Digital/analog layout complete - ready to review
    [AnalogPCB.kicad_pcb, AnalogPCB.kicad_sch, DigitalPCB.kicad_pcb, DigitalPCB.kicad_sch]
2025-05-08 PCB - Digital CAD Finished
    [DigitalPCB.kicad_pcb]
2025-05-09 PCB - Analog Routing Begin
    [AnalogPCB.kicad_pcb]
2025-05-09 PCB - Analog AC routing first pass
    [AnalogPCB.kicad_pcb]
2025-05-09 PCB - Analog AC routing half done
    [AnalogPCB.kicad_pcb]
2025-05-10 PCB - Analog routing complete, need final review
    [AnalogPCB.kicad_pcb]
2025-05-10 PCB - digital routing underway
    [DigitalPCB.kicad_pcb]
2025-05-11 PCB - digital routing halfway done
    [DigitalPCB.kicad_pcb]
2025-05-12 PCB - digital routing first pass done
    [DigitalPCB.kicad_pcb, DigitalPCB.kicad_sch]
2025-05-12 PCB - hopper pcb done routing ready for review
    [DigitalPCB.kicad_pcb, DigitalPCB.kicad_sch, LightSensorPCB.kicad_pcb]
2025-05-13 PCB - Text edited, all ready for review
    [AnalogPCB.kicad_pcb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]
2025-05-13 PCB - Hopper PCB reviewed and gerbers generated
    [LightSensorPCB-B_Cu.gbl, LightSensorPCB-B_Mask.gbs, LightSensorPCB-B_Paste.gbp, LightSensorPCB-B_Silkscreen.gbo, LightSensorPCB-Edge_Cuts.gm1, LightSensorPCB-F_Cu.gtl, LightSensorPCB-F_Mask.gts, LightSensorPCB-F_Paste.gtp]
2025-05-14 PCB - Analog pcb under review and making minor mods - diode placement
    [AnalogPCB.kicad_pcb, AnalogPCB.kicad_sch]
2025-05-15 PCB - Analog pcb complete review and gerber generated
    [AnalogPCB.kicad_pcb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]
2025-05-20 PCB - gerbers generated and boms started
    [AnalogPCB-BOTTOM.gbl, AnalogPCB-B_Mask.gbs, AnalogPCB-B_Paste.gbp, AnalogPCB-B_Silkscreen.gbo, AnalogPCB-Edge_Cuts.gm1, AnalogPCB-F_Mask.gts, AnalogPCB-F_Paste.gtp, AnalogPCB-F_Silkscreen.gto]
2025-05-25 PCB - consolidated BOM - Ordered Components
2025-05-26 CAD - Spacer for digital and analog boards
    [DigitalAnalogSpacer.step]
2025-05-30 CAD - Faceplate Rev 01
    [ControllerFaceplate01.step]
2026-04-07 create interface sensor class for general sensor handling
2026-04-07 Add ambient light sensor class based on main.cpp
2026-04-08 imu header file
2026-04-08 restructure and bug fixes in light sensor code
    [IMU.cpp, IMU.h, LightSensor.cpp, LightSensor.h]
2026-04-08 IMU sensor updates
2026-04-08 Temperature based CPP improvements
2026-04-10 PID header complete
2026-04-16 PID math baseline
2026-04-16 PID complete'
2026-05-31 Bug fixes and state machine development
    [DisplayController.cpp, StateMachine.cpp, StateMachine.h]
2026-06-01 State machine and encoder work
2026-06-01 Encoder hold developemnt
2026-06-02 encoder input developement
2026-06-02 Add sensor manager to handle simultenous updates of all sensors, header complete
2026-06-03 Sensor manager cpp development
2026-09-20 Start rev C pcb, with analog first. Update passives to 0805
    [AnalogPCB.kicad_pcb, AnalogPCB.kicad_sch]
2026-10-16 Digital board revisions, changed to 0805 and started review of circuitry
2026-10-16 begin change of power arch so mux occurs at 5.0v rather than 3.3v
